kingkongola/lowrider/machine/delar/nollpunkt/fallarm_C_allt.jpg

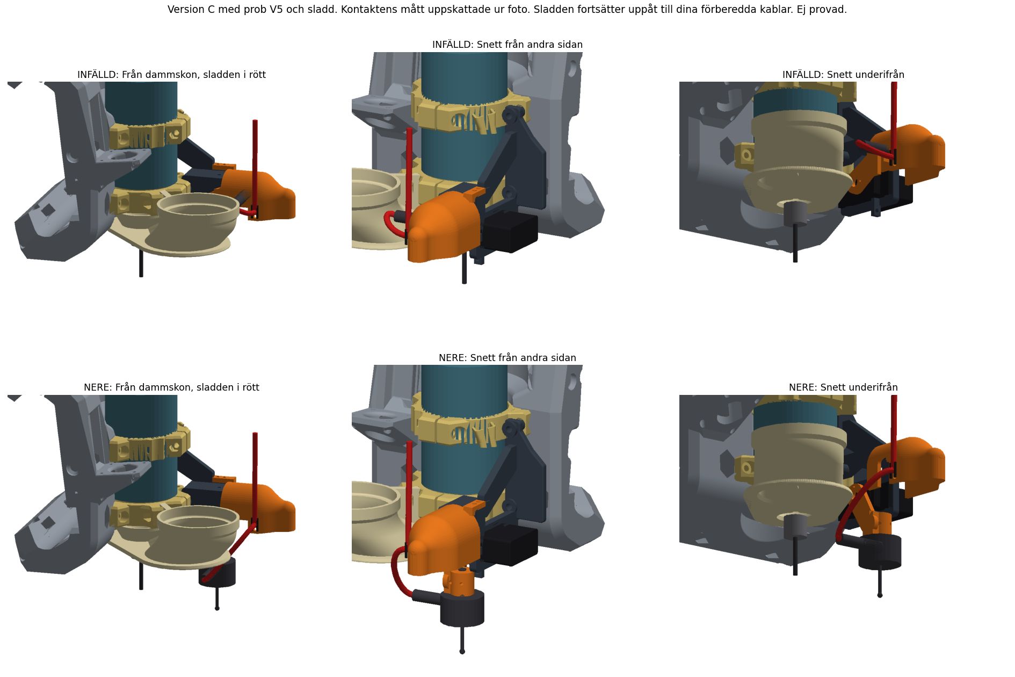
machine/delar/nollpunkt/fallarm_C_allt.jpg
