kingkongola/lowrider/README.md

# LowRider V4

Det här repot är single source of truth för den LowRider V4 som faktiskt byggs.

> **Läs detta först (2026-11-09):** De första avsnitten nedan är en **historisk bygg-/inköpssnapshot från september**, inte uppdaterad maskinstatus. LowRidern är **byggd och har fräst**, offerskivan planades senast 2026-10-22 och den permanent monterade mekaniken beskrivs i `BUILD_LOG.md`. Gällande **repo-konfiguration** pekas ut av `machine/AKTIV`; fysisk mätstatus finns i `CALIBRATION.md`, sensorbeställningar i `PROCUREMENT.md` och sensorernas design-/teststatus i `cnc/docs/PROJEKTJOURNAL_SENSORER.md`. **Z-nivå ännu inte verifierat färdig**, men squaring godkändes efter struts den 13 oktober (0,5 mm diagonalskillnad). Läs inte den äldre monteringsordningen som återstående arbete.

## Aktuell LED-status — beslut D022, 2026-11-10

**G4-lampor är ersatta av BRIMETI 24 V COB-list**, 4000 K/8 mm/320 LED/m, 5 m för angivna 145 kr Prime (10 W/m och 100 lm/W enligt säljaren). Tre banor under **horisontell understrut**, en nedåt och två framåt. **G4 ska inte köpas eller ritas till detta bygge.** [Låst komponent-/principval](DECISIONS.md#d022--cob-list-ersätter-g4-lampor-för-lowrider-belysning), [samlad SSOT för LED/el](machine/EL_BELYSNING_OCH_STOPP.md), [parametriskt CAD-utkast och spärrar](machine/delar/led/README.md). Aktuell build123d är **lågprofil med hårt Z-tak 6,65 mm för fästet** och startvinklar **0°/15°/35°**. Både 90°-felvänd version och tidigare cirka 21 mm hängande fäste är ersatta; **ingen fysisk passning, bild- eller temperaturtest godkänd**. Matning och NVR/automatisk övervakningsstopp är fortfarande öppna konstruktionsfrågor.

## Aktuellt läge — 2026-09-21

- Maskin: **LowRider V4**. PrintNC/IndyMill är inte aktiva alternativ.
- Arbetsyta: **650 × 1250 mm**.
- Geometri: rör **816 / 816 / 1505 mm**, Ø30×1,5 mm; strut-input **819 mm**; GT2 **999 / 1705 / 1705 mm**; minimum bord **941 × 1563 mm**; praktisk deck cirka **1000 × 1620 mm**.
- HaWiWe-order: **betald 1 853 kr och mottagen**, enligt användarens uppgifter. Ordervaluta 165,50 € inkl frakt. Innehåll: 6,0 mm XZ-plattor, 4 × MGN12H 150 mm, LR4 screw set och Makita/Elaire 1/8" collet.
- Controller: **Elecrow Jackpot3 `CQA240812C2` är mottagen**, faktisk debitering **937 kr** inklusive DDP Economy.
- Drive pulleys: **3 × GT2/2GT 16T / 5 mm bore / 10 mm belt är köpta via eBay/POWGE**, faktisk debitering **72 kr**, fri frakt och importavgifter inkluderade i eBay-köpet.
- LaskaKit-mekanikkärna: **mottagen**, 444 kr. Innehåll: 6 smooth idlers, T8×8 400 mm, 2 × 5→8-koppling och 5 m GT2 10 mm glasfiber. **4 × ersättnings-T8×8-mässingsmuttrar från Amazon är mottagna** (2 används + 2 reserv).
- Faktiskt betalt inklusive bordsskivan: **6 756,11 kr brutto**; **6 689,11 kr** exklusive 67 kr annullerad eBay-order som väntar återbetalning. Se `COSTS.md`.
- Mekanikinköp: grundmekaniken inklusive **3 × eBay/POWGE 16T-remhjul är mottagen**. Verifiera fysisk passning och antal mot beställningsspec innan montering. Köp inte T8-muttrar igen.
- Printer: **Bambu Lab P1S**; alla diameterberoende LR4-printar ska vara **30 mm-variant**, tool mount **Makita/65 mm**.
- Router: **KATSU 101750**, 710 W, cirka 65 mm; köpt.
- Filament: **3 kg PLA från PrintOnion** för 426 kr; utskrifterna är igång.
- Bord: **180×100 cm bordsskiva köpt för 300 kr**; ingen planerad 90 cm-kantbreddning, kontrollera underrede. Löstagbar ~12 mm MDF-spoilboard köps senare.
- Garagegrupp: **10 A**, praktiskt beprövad med svets; CNC är inte ett öppet elproblem om säkringen faktiskt håller.
- Dammhantering är del av grundbygget.
- **Maskinen körd 2026-10-04:** Jackpot3 (FluidNC 3.9.9, 192.168.50.184) styr maskinen; limits och homing fungerar. Kalibrering steg 1 (steps/mm **X 50,0835 / Y 50,2054**) och steg 2 (squaring, diagonalskillnad 1,6 mm; Y motor0 pulloff 6,2) är klara; steg 3 (Z-nivå) är uppskjutet till efter permanenta struts och planfräst offerskiva. Protokoll, mått och config-backuper: `CALIBRATION.md`, `machine/`. Squaring/Z-nivå görs om efter permanenta struts.
- Prints: användaren har rapporterat utskrift av **platta 14/14** samt att **hela Core är omprintad utan tidigare 0,20 mm förskjutning**. Den tidigare defekta Core används inte. **Det är inte bekräftat att det separata Makita/65 mm-verktygsfästet (eller Jackpot3-boxen) ingick i dessa plattor.** Se LR-00 och inventera utskrifterna före Core-montage.
- 3 × 16T-remhjul från eBay/POWGE: **mottagna 2026-09-21** enligt användaren; antal och tekniska mått kontrolleras under nästa inventering.
- Projektkostnad inklusive köpt bordsskiva: **6 756,11 kr brutto**, **6 689,11 kr** exklusive annullerad eBay-order på 67 kr som väntar återbetalning.

## Kanoniska filer

- `DECISIONS.md` — låsta beslut och explicita supersessions.
- `BOM.md` — exakt vad bygget behöver och vad som redan finns/köpts.
- `PROCUREMENT.md` — **enda kanoniska ordermatrisen** för kvarvarande köp.
- `COSTS.md` — **enda kanoniska kostnadsledgern**; faktiskt debiterade SEK-belopp.
- `CHECKLIST.md` — nästa arbete i fysisk ordning.
- `AUDIT.md` — mekaniska/elektriska/fysiska gates; innehåller inte flyktiga priser.
- `SOURCING.md` — daterad sourcing-evidens och länkar; ska inte duplicera en alternativ BOM.
- `TABLE.md` — bord/deck.
- `BUILD_LOG.md` — historik; gamla val får finnas här som historik men är inte current state.
- `WORK_ORDERS.md` — arbetskort om cirka en timme, med beroenden och återrapportering; lokal webbsidestatus är inte SSOT.
- `CALIBRATION.md` — kalibreringsprotokoll (steps/mm, squaring, Z-nivå) och enda mätloggen; baslinje-config i `machine/`.
- `CABLE_ROUTING.md` — kabellager, routing, mätprotokoll och verifierade kapmått (ännu tomma innan fysisk full-travel-kontroll).
- [`machine/EL_BELYSNING_OCH_STOPP.md`](machine/EL_BELYSNING_OCH_STOPP.md) — aktuellt 2026-11-10: 24 V-LED (ned/fram/fram), tillgängliga nätaggregat, separat övervakningsmatning, tänkt automatisk frånkoppling och återstående verifieringar. Inget färdigt elschema eller LED-klips.

## Monteringsguide

**Granskning 2026-09-29:** [resultat och öppna byggkontroller](AUDIT_2026-09-29.md). Rörgeometrin är omkontrollerad; T8 kräver provpassning före kap, kablar mäts en i taget och LR-22 ska godkännas före motorprov. Beräknade remlängder nedan skiljs från extra grovkapmarginal i manualen.

- [`docs/MONTERING_SV.md`](docs/MONTERING_SV.md) — svensk, utökad monteringsguide för den faktiska LR4-konfigurationen med **Jackpot3**. Läs tillsammans med V1E:s originalbilder; guiden ersätter inte kanoniska beslut eller checklistan.
- [Publicerad guide och arbetsordrar](https://kingkongola.github.io/lowrider/) — originalbilder inline, 30 entimmespass och kopierbar återrapport. Lokal status på webbplatsen synkas inte automatiskt med repot.
- `research/` — historisk evidens. Top-level-filerna ovan supersederar research vid konflikt.

## Sensorutbyggnad 2026-11-08

- [**Gemensam projektjournal**](https://github.com/kingkongola/cnc/blob/main/docs/PROJEKTJOURNAL_SENSORER.md) — historik, beslut, motiv, antaganden och nästa steg. Håll ingen kopia här.
- [Sensorarm: inkopplings- och provgrind](machine/delar/nollpunkt/INKOPPLING_OCH_PROV.md) — dokumenterad kontroll före **eventuell** inkoppling; inga steg fysiskt verifierade.
Enligt användaren är kamera, mikrofoner, accelerometer och BLTouch nu **beställda, ej mottagna**. [Orderstatus och obekräftade exakta orderrader](PROCUREMENT.md); [mjukvaruarkitektur och kodstart i cnc](https://github.com/kingkongola/cnc/blob/main/docs/sensorarkitektur.md). Sensorfunktionerna är inte monterade eller driftsatta.

## Pågående experiment och automationsidéer

- [Automatisering och kamera – idéer 2026-11-06](docs/AUTOMATISERING_OCH_KAMERA_2026-11-06.md): krav på kamerasystemet, Tapo/Coral, BLTouch på servoarm, vakuumfastspänning, Genie-frammatning/indexering, billig verktygsväxling och manuell tvåsidig registrering. **Forsknings- och provplan, inga låsta konstruktionsbeslut.**

## Aktuell arbetsordning

1. Inventera utskrivna LR4-delar. **Kontrollera explicit om det separat nedladdade Makita 701/65 mm-verktygsfästet finns; vid frånvaro skriv ut det enligt LR-00.** Verifiera även 30 mm-varianter, rätt Jackpot3-box och **4 × temporära struts (15 % infill)**. Platta 14/14 innebär inte att separat mount-set automatiskt ingick.
2. Kontrollera köpta 180×100-skivans underrede/styvhet och provlägg rail/belt-layout. Mät/kapa rör efter OD-/rakhetskontroll.
3. Inventera HaWiWe, DigiKey, remhjul och el-/kabeldelar mot BOM. Alla tre beställda 16T-remhjul är mottagna; kontrollera tänder/hål/rembredd före montering.
4. Köp/ordna ~12 mm MDF-spoilboard, 5–6 mm strutmaterial, första 3,175 mm-fräs samt NVR/kapsling efter fysisk dry-fit.
5. Montera maskinen med temporära struts, konfigurera Jackpot3, torrkör och fräs permanenta struts (`819`, `front_wing_size=10.8`) med maskinen själv.
6. Byt till permanenta struts, gör full-travel-test för kablar/slang, färdigställ dammhantering och planfräs offerskivan.

Bred komponentresearch ska inte återöppnas utan ett konkret pris-, lager-, kompatibilitets- eller integrationsproblem.
