kingkongola/lowrider/CHECKLIST.md

# Checklist

## LED-belysning – aktuellt beslut 2026-11-10 (D022)

- [x] **Valt komponent-/funktionsval:** BRIMETI COB 24 V / 4000 K / 8 mm / 320 LED/m; **G4-lampor utgår**. Rulle 5 m, uppgivet 10 W/m; 145 kr med Prime enligt användaren. Faktisk betalning/mottagning ej bekräftad.
- [x] Parametrisk **build123d-lågprofil** i [`machine/delar/led/tre_vinklar.py`](machine/delar/led/tre_vinklar.py): horisontell understrut, 3 × LED-riktningar med **provvinklar 0°/15°/35° och 9 mm hyllbredd för 8 mm LED**, och **hård Z-budget 6,65 mm för enbart fästet** under plattan. **Både felvända 90°-CAD:n och tidigare ~21 mm nedsänkta pelarversionen är ogiltiga.**
- [ ] Verifiera build123d-export i CI och att rätt STEP/STL ligger i aktuell artefakt; inga gamla STL/STEP.
- [ ] Kontrollera att aktuell CAD-export från build123d innehåller **rundade hörn och 0,2 mm hyllkantfas i **den nya 1,6 mm tunna hyllan****, inte bara den äldre kantiga modellen. Provprinta en ny export, inte tidigare uppladdad STL/STEP.
- [ ] Kontrollera **längsgående kantstag från lägre sidan av 15°-/35°-hyllorna upp mot 0,9 mm överdel**, anslutning mot central skruvad bas och böjstyvhet vid fria ändar; kontrollera att stagen är bakom ljusytorna. Kontrollera verkligt CAD-intrång **≤6,65 mm för själva fästet relativt understrutten** och mät separat LED-listens/tejpens tillkommande Z och verklig maskinfrigång med fräs/dammsko/arbetsstycke. Provprinta **ett** PETG-fäste; kontrollera två M5/Brace-låspunkter (56 mm c/c), skruvgrepp och hel XYZ-frigång innan full montering.
- [ ] Prova kort LED-sektion på PETG, 24 V och fullt ljus: yttemperatur, tejpens vidhäftning och kamerans skuggor/reflexer. **Aluminiumprofil är inte ett beslutat inköp.**
- [ ] Planera **3 × parallella lödda LED-grenar**, isolerade lödpunkter och dragavlastning, och en gemensam tvåledarmatning på balken. Prova först befintlig passage/kant; **om borrning krävs**, märk en enda genomföring efter kontroll av platta, M5/Brace, båda sidor och full XYZ, avgrada och skydda kabeln. Ingen hålposition eller diameter beslutad.
- [ ] Verifiera befintliga aggregat och dimensionera separat matning för installerad LED-längd; Pi/övervakningen ska fortsatt fungera efter maskinstopp. El-/stoppkrav: [`machine/EL_BELYSNING_OCH_STOPP.md`](machine/EL_BELYSNING_OCH_STOPP.md).

## 1. Beställningar — nu

- [x] LaskaKit mekanikkärna — köpt 2026-09-03 för **444 kr faktiskt debiterat**
- [x] 4 × **T8×8 brass nut, 2 mm pitch / 4-start / 8 mm lead** — Amazon.se/euroharry, **101,76 kr visat orderpris**, **mottaget 2026-09-10**
- [x] 3 × GT2/2GT drive pulley **16T / 5 mm bore / 10 mm belt / 2 mm pitch** — eBay/POWGE, **72 kr**
- [x] DigiKey — PSU, endstops, 608-lager, Wago, glands, Faston, kablage och pigtails, **986,98 kr**; **mottaget/hämtat 2026-09-09**
- [x] 5 × STEPPERONLINE `17HS19-2004S1` — Amazon.se, **608,37 kr visat orderpris**
- [x] Elecrow Jackpot3 `CQA240812C2` — **937 kr**
- [x] KATSU `101750` router — Amazon.se, **620,00 kr visat orderpris**
- [x] **3 kg PLA 1,75 mm från PrintOnion** — **426 kr**
- [x] **2 × Motonet-rör** — köpt 2026-09-07 för **340 kr totalt**; planerad spec Ø30×1,5×2000 mm

**Kärnmekanik, elektronik, router, filament och rör är köpta/beställda. Alla 3 × 16T-remhjul är mottagna 2026-09-21; kontrollera fysisk specifikation vid inventering.**

## 2. Lokalt / fysiskt

- [ ] räkna av DigiKey-paketets innehåll mot BOM före montering
- [ ] verifiera de köpta Motonet-rörens faktiska OD/rakhet/längd före kapning
- [ ] kapa rör först därefter: 1505 / 816 / 816
- [x] **180×100 cm bordsskiva köpt för 300 kr**, rapporterat 2026-09-19
- [ ] kontrollera underredets styvhet, höjd och infästning; ordna eventuell förstärkning bara vid behov
- [ ] markera 941×1563 mm footprint på den köpta skivan och kontrollera rail/belt-zoner; **ingen 90 cm-kantbreddning behövs**
- [x] 3 × 16T-remhjul från eBay/POWGE mottagna 2026-09-21
- [ ] kontrollera 16T, 5 mm hål och kompatibilitet med 10 mm GT2-rem före montering

## 3. När HaWiWe anländer

- [ ] kontrollera transportskada
- [ ] kontrollera fyra produktgrupper: XZ-plattor, 4 rails, screw set, collet
- [ ] provmontera M3×10 mot 6,0 mm XZ/MGN-block; inget bottnar/binder

## 4. Prints

- [ ] hämta senaste LR4-filer
- [ ] verifiera **30 mm** på alla railberoende delar
- [ ] **kontrollera om Makita/65 mm-verktygsfäste verkligen är utskrivet**. Det ingår inte bekräftat i våra 14 MakerWorld-plattor; V1E listar det som separat [Makita 701 Tool Mount and Dust Shoe](https://www.printables.com/model/1033926-makita-701-tool-mount-and-dust-shoe-for-the-lowrid).
- [ ] om fästet saknas: välj rätt 65 mm-variant för KATSU 101750; slic:a och skriv ut enligt modellbeskrivningen (V1E:s deltabell anger 30 % infill); kontrollera passning före Core LR-07. Se arbetsorder LR-00.
- [ ] kontrollera separat om **Jackpot3 board box** är utskriven (V1E länkar till en separat modell); anta inte att den följer med grundplattorna.
- [ ] provprinta `Z_Stub` + `Z_Nut`
- [ ] kontrollera passning; **Core är helt omprintad utan den rapporterade 0,20 mm förskjutningen** — denna felanmärkning gäller inte den nya Core
- [ ] granska slicer bridges/unsupported geometry
- [ ] inventera utskrifterna efter att användaren rapporterat platta 14/14: grundplattornas status, separat tool mount, Jackpot3-box och temporära struts verifieras var för sig.
- [ ] printa **4 × temporära struts, 15 % infill** för första monteringen
- [x] **monterade 2026-10-22 enligt användaren.** generera permanenta front-/bottenstruts med `strut_length=819`, `front_wing_size=10.8` (5–6 mm MDF/hardboard, max 6,35 mm); fräs med färdigmonterad LR4 och byt sedan ut temp-struts

## 5. Bord / spoilboard

- [ ] använd den köpta **180×100 cm** bordsskivan direkt som strukturell maskinbas, förutsatt godkänt underrede
- [ ] köp **inte** hel OSB/ply-deck om inte verkligt behov uppstår
- [ ] planera rail/belt-infästning på 180×100-skivan, utan tidigare planerad 90 cm-kantbreddning
- [x] offerskiva fastskruvad, rapporterat 2026-10-07 (material/tjocklek ej rapporterat; inte planfräst)
- [x] offerskivan planfräst (`plan07`, 0,7 mm), rapporterad plan 2026-10-22
- [ ] inget T-track före faktiskt behov

## 6. Mekanik

- [ ] montera gantry/Y/Z
- [ ] provpassa T8 på båda YZ-sidorna före kapning enligt manualens kapitel 0; 150 mm är provmått, D014:s 150–160 mm är inte automatiskt godkänt
- [ ] kontrollera lätt Z-rörelse utan binding
- [ ] kontrollera hela 5 m-rullens fördelning före första klippet: V1E beräknat 999 / 1705 / 1705 mm; vår extra grovkapmarginal ger minst 1029 / 1735 / 1735 mm. Trä remmar i LR-08/09/10; slutspänn efter LR-16
- [ ] montera 16T/rem/idlers
- [ ] montera KATSU `101750` i Makita/65 mm mount
- [ ] provpassa Elaire-collet
- [ ] kontrollera runout
- [ ] kontrollera fri manuell rörelse över hela slaget
- [ ] squara maskinen

## 7. Damm

- [ ] bekräfta DeWalt-typskylt
- [x] printa LR4 dust shoe (dammsugning monterad 2026-10-22 enligt användaren)
- [ ] prova befintlig TPU till bristles
- [ ] printa cyklon: **eifelbiker "Cyklonseparator med undertrycksventil"** (MakerWorld, `Zyklon.3mf`), P1S-profil, PLA, 3–4 väggar, ~18,7 h; TPU-packningar (separat profil, 1,7 h); egna 46 mm-stosar mot slangen; ventilens fjäder 0,5×6×20 mm + M3x25/M4x35 + mutterinsatser M3/M5 behövs. Utskrift påbörjad 2026-10-16 (användarens rapport); ej verifierad klar.
- [ ] ordna 15–30 l styv behållare
- [ ] vakuumtesta behållare/lock kontrollerat
- [x] **Slang finns redan:** 4 meter poolslang, ID 46 mm (uppmätt 2026-10-14); användaren har använt den med DeWalt för att rengöra FTX-kanalerna. Inget nytt slanginköp behövs i nuläget. DeWalt-originalslang är för kort.
- [ ] **Anpassa och verifiera sugslang på LowRider:** dammsugaren monterad 2026-10-22 enligt användaren; slangmått mätt (ID 46 mm) och adapter till Makita-dammskon printad (`slangadapter_46mm`, cnc-repot); kvar: ordna upphängning/dragavlastning och prova full X/Y/Z-rörelse. Beakta att vanlig poolslang normalt inte är antistatisk.
- [ ] bygg slangavlastning
- [ ] lös statisk jordväg före XPS/reguljär MDF/trä-drift

## 8. Controller/lågspänning

- [ ] inventera data-USB-C
- [ ] inventera FAT32 microSD >2 GB
- [ ] när Jackpot3 anländer: kontrollera transportskada/korrekt kort
- [ ] montera Jackpot3 luftigt på rörlig beam/YZ_Min-sida
- [ ] provplacera även HDR-60-24 på balken; verifiera skyddad 230 V-anslutning, kapsling, DIN-infästning, ventilation och dragavlastning innan anslutning; HDR är klass II utan PE-plint
- [ ] flasha V1E:s då aktuellt testade FluidNC + rätt LR4-config
- [ ] koppla motorer
- [ ] första jogg 1 mm först efter godkänd nätmatning/stopp (LR-22), kabeldragning och brytarprov
- [ ] **LR-08: BEKRÄFTAT PASSNINGSFEL:** köpta 3×26 AWG-kabelns cirka Ø4 mm mantel går inte genom Core. **Tvinga inte in den.** Prova individuellt isolerade innerledare enbart genom tunneln med oskadad isolering, avlastad mantel utanför och skavskydd; alternativt tunnare flexibel tvåledarkabel/skyddad yttre dragning. Kontrollera även YZ-kanalernas passning. Förbered med märkt dragtråd om kabelvägen ännu inte är mätbar; vid LR-16 mäts och kapas en brytarkabel i taget från rullen. **250 cm är inte verifierat kapmått.** LR-16: kontrollera full rörelse och kapa först efter faktisk dragning.
- [ ] koppla 5 endstops NC via COM+NC
- [ ] verifiera varje endstopstatus

## 9. NVR/elbox + full travel

- [ ] välj NVR efter faktisk variant/schema; Clas Ohlson KJD12 230 V/10 A är aktiv kandidat
- [ ] dry-fit fast NVR och balkmonterat HDR-60-24 med separat beröringsskydd; bestäm kapsling och håltagning först efter fysisk kontroll
- [ ] placera stoppet direkt nåbart
- [ ] dry-fit kort 24 V-rutt mellan balkmonterat HDR-60-24 och Jackpot3; den köpta 3 m-kabeln är reserv, inte obligatorisk rörlig slinga
- [ ] dry-fit säker nätmatning till balkmonterat HDR-60-24
- [ ] dry-fit KATSU-kabel
- [ ] dry-fit motor/endstop
- [ ] montera vac-hose samtidigt
- [ ] kör manuellt alla fyra hörn + Z-extremer
- [ ] slutlig dragavlastning först efter godkänt full-travel-test

## 10. 230 V verifiering

- [ ] följ exakt terminalschema
- [ ] PE kontinuerlig/oswitchad
- [ ] kontrollera kabel-OD mot glands
- [ ] inga åtkomliga live-delar med boxen stängd
- [ ] kontinuitetstesta PE
- [ ] verifiera ingen L/N→PE-kortslutning
- [ ] verifiera NVR/no-restart med router frånkopplad

## 11. Driftsättning

- [ ] torrkör utan fräs
- [ ] verifiera full driven travel
- [x] kalibrering steg 1 (steps/mm) och 2 (squaring) enligt CALIBRATION.md, 2026-10-04
- [ ] kalibrering steg 3 (Z-nivå) efter permanenta struts (klart 2026-10-22) + planfräst offerskiva; gör om squaring då
- [ ] plana spoilboard
- [ ] kontrollera X/Y-mått + diagonaler
- [ ] kontrollera Z-djup
- [ ] fräs kalibreringsbit
- [ ] spara fungerande config-backup
- [ ] första enkla jobb i billigt material

## Senare — inte nu

- [ ] hel deck/torsionsbox endast om det faktiska bordet visar att det behövs
- [ ] Sorotec/extra fräsorder när första verkliga fräsbehoven är kända
- [ ] router-/stepperförlängning endast om dry-fit kräver
- [ ] T-track/insert-grid/vacuum-table efter erfarenhet
- [ ] laser tidigast 2027
- [ ] plasma utanför detta bygge
