kingkongola/lowrider/CABLE_ROUTING.md

# Kabeldragning och verkliga kabellängder — LowRider 4

**Status 2026-09-29: kaplängd ej verifierad.** För vår arbetsyta 650 × 1250 mm och Jackpot3 på YZ_Min finns **inget av V1E angivet exakt X-brytarkabelmått**. Tidigare förslag 250 cm var en oprövad uppskattning och har dragits tillbaka som kapinstruktion. Prova kabelpassningen i LR-08 och lämna märkt dragtråd om längden ännu inte kan mätas. Fastställ faktisk längd i LR-16; om 250 cm redan är kapat, behåll biten och prova räckvidden innan vidare kapning.

## Vad finns och vad är faktiskt känt?

| Kabel/del | Köpt längd/antal | Användning eller status |
|---|---|---|
| 5 × STEPPERONLINE 17HS19-2004S1 | **1 m fast motorkabel per motor** | Y0, Y1, Z0, Z1, X. Ändra inte motorernas fasta kablar. |
| Tensility 30-00377 | **10 m 3×26 AWG**, svart mantel cirka Ø4 mm | Fem NC-brytare, COM + NC. **ANVÄNDAREN HAR VERIFIERAT ATT MANTELN INTE PASSAR I CORE-TUNNELN.** Behåll manteln på rörlig del; pröva två separata individuellt isolerade innerledare endast i den trånga, fasta tunneln med skyddad övergång och avlastning. Alternativt tunnare flexibel tvåledarkabel/skyddad yttre kabelväg. Kontrollera passning även i YZ-kanaler. |
| Molex KK 2,54 mm 2-polig pigtails | **3 × 150 mm** | Kontaktförsörjning enligt BOM; matchning mot fysisk Jackpot3-ingång och antal behöver verifieras, särskilt eftersom fem brytare används. |
| Tensility 30-00416 | **3 m 2×20 AWG** totalt | Tidigare tänkt lång 24 V-slinga. Efter D016 behövs bara en kort HDR→Jackpot3-förbindelse på balken. Validera kabelarea, anslutningssätt och verklig ström innan användning. |
| 230 V till HDR och KATSU | Inget slutligt ruttmått | Rörlig kabelväg och beröringsskydd/PE/dragavlastning verifieras separat innan nätanslutning. Ingen kapning eller inkoppling enbart med detta dokument. |

**V1E:** [LR4 Core Assembly](https://docs.v1e.com/lowrider/#core-assembly) anger minst **140 mm fri ledning för eventuell touchplate** vid Core. Det är **inte** ett mått för X-brytaren. [Wire Routing](https://docs.v1e.com/lowrider/#wire-routing) anger förlängningar på Core och YZ_Max-sidan, full Z- och X-rörelse samt dragavlastade skarvar, men **inte exakta kapmått för vår maskinstorlek**. V1E:s BOM har tre motorkabelförlängningar som typkonfiguration.

## LED under horisontell understrut – plan 2026-11-10

**D022:** Tre 8 mm BRIMETI COB-banor under den horisontella understrutten (en ned, två fram). Varje remsa löds med +24 V/GND och parallellkopplas, sedan går **en gemensam lågspänningsmatning** mot valt LED-aggregat. För cirka 3 × 0,8 m gäller säljaruppgift 24 W totalt (~1 A vid 24 V). Ska inte antas få effekt från motorernas HDR-60-24.

**Håltagning:** undersök först befintlig öppning eller kabelväg via kant. Om kabelgenomföring krävs: borrning av **ett hål** är en möjlig metod, men **diameter och koordinat är inte mätta/beslutade**. Kontrollera båda sidor om plattan och verkliga M5/Brace-låspunkter, bärande smala sektioner, rör, rörelse/kollision. Hålet ska avgradas/skyddas och kabeln dragavlastas nära LED-lödningen och vid genomföringen. Inga nya hål i CAD före vald fysisk rutt. Lågspänningskabel och nätspänning ska inte samsas oskyddat. Märk kablar, säkra LED-grenen och fullfölj böj- och dragprov genom hela X/Y/Z-slaget.

[LED-CAD och kontrollgrind](machine/delar/led/README.md) · [Samlad el-/stopp-SSOT](machine/EL_BELYSNING_OCH_STOPP.md).

## Mätprotokoll – fylls efter fysisk provmontering, före kapning

| Ledning | Start → slut / faktisk väg | Köpt ledning | Mätt rutt inkl. rörelsemarginal | Slutlig längd | Funktion godkänd |
|---|---|---|---|---|---|
| X motor | Core → med Core till X_Max → avlastad mitt på balken → Jackpot3 YZ_Min | fast 1 m + ev. förlängning | — | — | ☐ |
| X NC | X-brytare → Cores tunnel → avlastad rörlig slinga via balkens mitt → Jackpot3 | passningsprov/dragtråd i LR-08; separat kabel från rullen vid LR-16 | prova fullt X-slag | ej fastställd | ☐ |
| Y0 motor | YZ_Min → kabelkanal → Jackpot3 | fast 1 m | — | — | ☐ |
| Y0 NC | YZ_Min-brytare → kabelkanal → Jackpot3 | ur 10 m 3×26 AWG | — | — | ☐ |
| Z0 motor | Z0 → YZ_Min-kanal → balk, med Z i full höjd → Jackpot3 | fast 1 m | — | — | ☐ |
| Z0 NC | Z0-brytare → samma Z-rörliga kanal → Jackpot3 | ur 10 m 3×26 AWG | — | — | ☐ |
| Y1 motor | YZ_Max → balk/stag → Jackpot3 YZ_Min | fast 1 m + ev. förlängning | — | — | ☐ |
| Y1 NC | YZ_Max-brytare → balk/stag → Jackpot3 | ur 10 m 3×26 AWG | — | — | ☐ |
| Z1 motor | Z1 → YZ_Max-kanal → balk/stag → Jackpot3 | fast 1 m + ev. förlängning | — | — | ☐ |
| Z1 NC | Z1-brytare → YZ_Max-kanal → balk/stag → Jackpot3 | ur 10 m 3×26 AWG | — | — | ☐ |
| HDR → Jackpot3 | Båda på balken, kort avlastad DC-rutt | ur 3 m 2×20 AWG endast om lämpad | — | — | ☐ |
| KATSU 230 V | Fast matning → hela Y-slaget → balk → hela X-slaget → fräs | befintlig fräskabel | — | — | ☐ |
| HDR 230 V | Fast NVR → hela Y-slaget → skyddad HDR-plint på balken | ännu inte valt | — | — | ☐ |
| Dammsugarslang | Dammuppsamling → avlastning → hela Y-/X-slaget → shoe | befintlig slang | — | — | ☐ |

**Praktisk ruttkontroll (projektmetod, inte V1E:s kapmått):**

1. **Vid LR-08 (Core):** den köpta **cirka Ø4 mm mantlade 3×26 AWG-kabeln passar bekräftat inte genom Cores tunnel**. Försök inte tvinga in den. För en fri ände från rullen kan du varsamt avlägsna *endast den korta del av ytterhöljet som faktiskt behövs för själva Core-tunneln och brytaranslutningen*; för två individuellt isolerade ledare genom tunneln om de går utan att nypas. Behåll manteln på hela den yttre rörliga kabelvägen. Avlasta manteln utanför Core; kontrollera skav/övergång och skadad isolering. Om lösningen inte är mekaniskt skyddad, välj tunnare flexibel tvåledarkabel eller säker yttre rutt. Märk `X`, anslut COM + NC enligt terminalmärkning och isolera oanvänd ledare. **Kapa inte hela kabeln vid Core.** Om kabelvägen inte är mätbar: lämna märkt dragtråd och färdigställ ledningen vid LR-16; behåll åtkomst till brytarens anslutning. En eventuell touchplate har separat kabel med V1E:s minst 140 mm fria längd.
2. **Vid LR-09/10 (YZ):** prova kabelpassningen och lägg separata märkta dragtrådar i kanalerna innan hjul och skenor blockerar åtkomsten; märk `Y0/Z0` respektive `Y1/Z1`. Fem separata kablar kan inte alla vara anslutna till samma okapade rulle. Redan kapade bitar används endast efter räckviddsprov. Prova Z genom hela slaget innan du fixerar ledningarna.
3. **Vid LR-13/16 (full maskin):** placera Jackpot3 på YZ_Min. Mät först alla fem brytarrutter med snöre inklusive rörelseslingor, kontakter och arbetsmån; summera och jämför mot återstående kabellager. Lägg sedan en verklig kabel i taget längs sin väg. Flytta Core till **X_Min och X_Max**, båda Z-sidorna till sina ytterlägen och balken genom **hela Y-slaget**. Lägg med fräskabel och slang i samma prov, och identifiera avlastade fixpunkter. Kabel ska vara fri även när maskinen går mot hörnen. V1E visar att X-ledningar går via Core och fästs ungefär mitt på balken.
4. **Mät och dokumentera varje ledning separat.** Lämna en mjuk service-/rörelsemarginal vid anslutningar och kopplingar – **cirka 10–15 cm kan vara en praktisk startpunkt, men är inte ett fast V1E-mått och måste anpassas efter rutt och böjradie.** För kort kabel eller stum förbindelse är inte godkänt. Fäst ledningar med avlastning före kontakt/skarv; motorförlängningar får inte bära draglast. Kablar som upprepat böjs måste vara avsedda för det.
5. **Kapning:** börja med X, använd dragtråden, anslut/avlasta brytaränden och mata fram till Jackpot3. Märk kapstället vid kortänden inklusive arbetsmån och eventuell pigtail; prova alla ytterlägen före klipp. Anteckna kaplängden och kvarvarande rulle. Upprepa för Y0/Y1/Z0/Z1 enligt den uppmätta fördelningen, inte en antagen 7,5 m-rest. Färdigställ fem verifierat passande kontakter (tre inköpta pigtails är inte fem). Överlängd kan förvaras dragavlastad på balken. Komplettera BOM endast vid faktiskt underskott.
6. **230 V:** bara planera mekanisk kabelväg i detta steg. Kabeltyp, PE, kapsling, dragavlastning, NVR och anslutning ska kontrolleras separat av elkunnig person. Den köpta lågspänningskabeln används inte för 230 V. HDR-60-24 har ingen PE-plint och är ingen jordpunkt; följ Mean Wells installationsmanual. LR-22 ska vara godkänd före första användning av HDR.

## Återrapport från LR-16

Skicka bilder på Jackpot3:s placering och kabelvägarna. Ange alla fem kaplängder, återstående kabel och kontaktlösningar, särskilt **vilken X-kabellängd som faktiskt räcker** genom fullt X-slag och om någon annan ledning är för kort eller behöver förlängning. Om 250 cm redan har kapats, ange om den biten fungerar. Överlängd får ligga dragavlastad.
