kingkongola/lowrider/TABLE.md

# Bord / underrede — aktuell status 2026-09-19

## Köpt och låst

- **180 × 100 cm begagnad bordsskiva köpt för 300 kr**, rapporterat 2026-09-19.
- LR4:s planerade arbetsyta: **650 × 1250 mm**; minimum ytterfootprint **941 × 1563 mm**.
- Den köpta skivan räcker för footprint på båda axlarna. **Ingen lokal kantbreddning för 90 cm-bord behövs.**
- Använd befintlig skiva som strukturell maskinbas om underredet är styvt och tillåter säker rail-/belt-infästning.
- Köpt skiva ingår i `COSTS.md`. Underredets faktiska skick, utformning och behov av förstärkning är **inte verifierat**.

## Gör nu

1. Verifiera underredets styvhet: tryck i hörnen, kontrollera glapp, sarg/tvärstag och beninfästningar.
2. Mät bordshöjd, skivans planhet och var det går att fästa rails, remclips, kabel och slang.
3. Markera 941 × 1563 mm och provlägg rörelsezoner innan du skruvar/borrar.
4. Köp endast underredesmaterial/förstärkning om kontrollen visar konkret behov.
5. Köp en löstagbar cirka **12 mm MDF-offerskiva** till arbetszonen; fräs den plan med färdigmonterad LowRider. Offerskivan behöver inte täcka hela bordsskivan eller bära rails.

## Köp inte i onödan

- Ingen ny bordsskiva eller full OSB-/plywood-deck som standard.
- Ingen kantbreddning avsedd för det tidigare alternativet 180 × 90 cm.
- Ingen T-track, vakuumbord eller torsionsbox före ett verifierat behov.
- Inga hjul före första fungerande maskinen.

## Bord, damm och el

Planera utrymme för befintlig DeWalt-dammsugare, printad cyklon, 15–30 l uppsamlingskärl samt slangavlastning. NVR/maskinstopp placeras fast och åtkomligt; Jackpot3 och, efter kontrollerat beröringsskydd/kapsling, HDR-60-24 planeras på rörlig balk enligt D016. Testa hela rörelseområdet för kablar och slang innan slutlig infästning.

Äldre 180 × 90-bordstrategi med ~41 mm breddbrist är **historik, inte aktiv köp-/byggplan**.

## Offerskivan

Hål (styrhål) och skruvar i offerskivan, i maskinkoordinater: `OFFERSKIVA.md`.
