kingkongola/lowrider/AUDIT_2026-09-29.md

# Granskning av svenska byggmanualen – 2026-09-29

**Resultat: konkreta instruktioner har rättats. Bygget är inte fysiskt slutgodkänt.** En genomgång av dokument kan inte garantera kapning, passning eller säker drift utan mätningar på de verkliga delarna.

Granskningen omfattar dagens inklistrade ändringshistorik, aktuell svensk manual/webbtext, kabelprotokoll, arbetskort, BOM, beslut och checklistor. Befintliga lokala manualändringar har bevarats och kompletterats. Inga inköp, leveranser eller fysiska byggmoment har markerats godkända.

## Kapmått och vad de betyder

| Del | Underlag | Åtgärd före kapning |
|---|---|---|
| X-rör | 2 × 816 mm | Kontrollera OD, rakhet och två lika färdiga längder; sågspår i spillet |
| Y-rör | 1505 mm | Kontrollera OD/rakhet och bordslayout |
| Stag | inmatning 819 mm, front_wing_size 10.8 | Inte rörmått. Kontrollera genererad ritning och CAM; långsidan längs Y |
| Remmar | beräknat X 999, Y 1705 + 1705 mm | Projektets extra grovkapmarginal: minst 1029 / 1735 / 1735 mm; markera alla tre på rullen först |
| T8 | V1E anger 145 mm eller längre; projektets provmått 150 mm | Verifiera båda sidors verkliga gängingrepp och frigång före kapning |
| Fem brytarkablar | inget fast kapmått verifierat | Mät alla rutter, kontrollera totalen och färdigställ en kabel i taget |
| Motorledningar | 1 m per köpt motor enligt BOM | Behåll hela; mät eventuellt förlängningsbehov |

Kalkylatorns aktuella JavaScript hämtades och räknades om med X=650, Y=1250 och XZ=6,0 mm. Formlerna ger X-rör 816, Y-rör 1505, stag 819, remmar 999/1705/1705 och minimum bord 941 × 1563 mm. Två 2000 mm-rör räcker med normal sågspårsbredd. Bordsskivan 1800 × 1000 mm rymmer det beräknade footprintet; dess styvhet och infästningszoner är fortfarande oprövade.

Källor: [V1E-kalkylator](https://docs.v1e.com/lowrider/calculator/) och [kalkylatorns kod](https://raw.githubusercontent.com/V1EngineeringInc/V1EngineeringInc-Docs/master/docs/lowrider/calculator.js). Material, montage och T8-specifikation jämfördes med [V1E LR4](https://docs.v1e.com/lowrider/).

## Fel och luckor som rättats

1. **T8 kapades för tidigt i texten.** Ett katalogmått på 145 mm bevisar inte vårt färdiga montage. Ovillkorlig 2 × 150 mm-kapning och påståendet om 5 mm avfasningsmån har ersatts med provpassning före kapning, enligt D014. Restlängden beror på sågspåret.
2. **För kort remrulle saknade stoppgräns.** Ingen automatisk nedkortning längre. Alla tre segment markeras före första klippet. 4499 mm är grovkapplanens nominella summa; tandmellanrum kan kräva liten avrundning uppåt. V1E:s beräknade summa är 4409 mm.
3. **Remmarginal framställdes som krav.** 30 mm är vår reserv. En redan kapad 999/1705 mm-rem döms inte ut bara för att den saknar reserv. Låsöglorna runt M3 skiljs från onödiga veck. Remkraft förväxlas inte med en vikt hängd mitt på remmen.
4. **Fem kablar skulle sitta kvar på samma rulle.** Dragtrådar och åtkomliga anslutningar används under tidigt montage. Därefter mäts hela kabelbudgeten och en separat ledning färdigställs åt gången. 10 m och 10–15 cm arbetsmån utlovas inte som tillräckligt utan mätning.
5. **Arbetskorten motsade manualen.** LR-08/09/10 trär remmar tidigt, LR-11 verifierar T8 före sågning och LR-16 levererar de färdiga brytarkablar som LR-20 förutsätter. LR-15 beror nu på LR-16.
6. **Motorprov kunde komma före elkontroll.** LR-21 kräver LR-22. Kapitel 7 kräver godkänd nätmatning före användning av HDR. Dokumenterade fel räknas inte som godkänd installation eller motorprov.
7. **HDR-montage och jordpunkt var otydliga.** V1E:s foto av ett annat aggregat ersätter inte Mean Wells DIN- och ventilationskrav. HDR-60-24 är klass II utan PE-plint. Slangjord ska inte improviseras via aggregatet eller DC-minus. Spänning och polaritet ska verifieras före anslutning av kortet.
8. **Första genomskärningen saknade tydligt offerskydd.** Offerunderlag behövs redan vid första provet; slutlig planfräsning kommer senare. CAM behöver kontrollerade enheter, nollpunkt, säker Z och verktygsbana. KATSU:s manuella drift anges uttryckligen.
9. **Stagets riktning i CAM var för valfri.** Cirka 819 mm ryms inte i 650 mm X. Långsidan läggs längs Y och hela banans yttergränser kontrolleras. Generatorns avsiktliga underlängd ska inte skalas bort.
10. **Webb och text behövde synkas.** Även maskinöversikten visas i förberedelserna. Bildernas stegplacering har kontrollerats; Jackpot3-kopplingen använder rätt kortbild. Ändrade kontrollrutor får inte ärva ett godkännande för en annan instruktion.

Elunderlag: [Jackpot3](https://docs.v1e.com/electronics/jackpot3/), [HDR-60 datablad](https://www.meanwell.com/Upload/PDF/HDR-60/HDR-60-SPEC.PDF) och [HDR installationsmanual](https://www.meanwell.com/Upload/PDF/HDR%20DIN%20rail%20power%20supply.pdf). Jackpot3-dokumentationen anger vid denna kontroll FluidNC 3.9.9/WebUI V3. Installerad firmware och verklig config har inte lästs från användarens kort.

## Fysiska kontroller som fortfarande behövs

- Rörens diameter/rakhet, XZ-plattornas tjocklek och skruvarnas gängingrepp.
- T8-muttrarnas passning samt godkänd längd/frigång på båda sidor.
- Kompletta 30 mm-printar, rätt fräsfäste, Jackpot3-box och bordets styvhet.
- Core-kabelns skyddade passage; fem passande brytarkontakter (BOM listar bara tre pigtails); verkliga motorförlängningar.
- Verklig NVR-modell, kapsling, nätinstallation, stopp/återstartsskydd och uppmätt DC-matning.
- Fräshylsans passning, verktygsinfästning, dammsko, slang, behållare och separat bedömd statisk jordväg.
- Full rörelse med samtliga kablar/slang, brytarprov, homing och måttprov före större fräsjobb.

Fyll faktiska resultat i [CABLE_ROUTING.md](CABLE_ROUTING.md), [CHECKLIST.md](CHECKLIST.md) och [BUILD_LOG.md](BUILD_LOG.md). Använd [manualens kapitel 0](docs/MONTERING_SV.md) som kapunderlag; detta protokoll ersätter inte monteringsstegen.

## Kontroll av dokumentleveransen

- Alla 12 webbkapitels texter jämförda med markdown-källan, inklusive maskinöversikten.
- Alla 31 arbetskort jämförda mellan markdown och JSON; beroendena saknar cirklar och innehåller kabel-/elkontroller före beroende moment.
- 159 bildposter har giltiga placeringar. Alla kapitel renderades i kodkontroll och öppnades via direktlänk i lokal webbläsare; inga konsolfel registrerades. Automatiserade klick i förhandsvisningen gav ingen synlig effekt, så knappnavigation är inte verifierad genom det provet.
- JavaScript-syntax och `git diff --check` godkända. Ingen fysisk maskinprovning utförd.

Ändringarna är lokala i repot. Ingen publicering till GitHub Pages har gjorts i denna granskning.
