kingkongola/lowrider/research/2026-08-29-table-live-candidates.md

---
research_date: 2026-08-29
last_updated_at: 2026-08-29
scope: live used-table candidate pass for the locked ~1000x1620 LR4 deck, focused on Gävle/Gävleborg
status: recommendation-ready
decision_state: no purchase-ready jackpot table is verified yet; one current 700 SEK Gävle lead is worth checking for dimensions/underframe, while two earlier search leads could not be re-verified and must not be treated as live
price_basis: indexed marketplace observations checked again 2026-08-29; availability, dimensions and seller details must be verified on the live listing before pickup
region: Gävle / Gävleborg / Sweden
sources_checked:
  - Relovie Gävleborg current matbord aggregation
  - Blocket current matbord search/index
  - Blocket current Gävle furniture index
supersedes: null
---

# Live table candidate pass — Gävle, 2026-08-29

This pass applies the already-locked rules in `TABLE.md` and `research/2026-08-29-table-base-local-sourcing.md` rather than reopening table architecture.

## Locked buy target

Preferred geometry:
- 1800×1000 mm — jackpot
- 1800×900 mm — very good
- roughly 1600–1800 × 850–1000 mm can work if the underframe is genuinely stiff

Price rule:
- 0–400 SEK: strong buy if dimensions + racking test pass
- 400–700 SEK: normal Pareto zone
- 700–1000 SEK: only for clearly excellent commercial/stiff construction
- >1000 SEK: normally wait

The practical LR4 deck remains ~1000×1620 mm, so an 1800×900 table only leaves 50 mm deck overhang on each long side.

## Current verified lead

### Gävle — “FYNDA!! Robust matbord i fint skick” — 700 SEK

Current Relovie Gävleborg aggregation, crawled 2026-08-28, shows:
- location: **Gävle**
- title: **FYNDA!! Robust matbord i fint skick**
- condition: **Bra skick**
- price: **700 SEK**

Source:
- https://relovie.com/k/hem-inredning/mobler/bord/i/gavleborg?type=matbord

### What is *not* verified yet

The indexed aggregation does **not** expose enough information to verify:
- length
- depth
- exact underframe construction
- whether “robust” means low racking rather than just a thick-looking top

Therefore this is **not purchase-ready yet**.

Next action for this lead:
1. open the underlying seller listing if still active
2. verify exact L×D×H
3. inspect/ask for underside/leg-frame photos
4. only pursue if geometry is roughly inside the locked target and the physical racking test can be done before pickup

At 700 SEK it must be a genuinely good 180×90/100-class table; merely being a usable table is not enough.

## Earlier leads that are NOT currently verified

An earlier search pass mentioned:
- a Gävle table around **180×95 cm**, reportedly bortskänkes
- a Gävle **180×90×76 cm** table around **900 SEK**

Fresh targeted searches on 2026-08-29 did **not** reproduce either listing reliably. They may have been removed, stale-indexed, or inadequately identified in the earlier pass.

**Do not treat either as current stock or a buy recommendation.** They can be reconsidered only if the live listing is found again.

This corrects the earlier conversational shortlist rather than preserving uncertain marketplace claims as facts.

## Market liquidity check

The wait-for-a-good-table strategy still holds.

Current indexed signals checked 2026-08-29:
- Relovie reports **228** used matbord in Gävleborg across three aggregated marketplaces.
- Blocket's broad current `matbord` index shows **167** results in Gävleborg.
- Blocket's Gävle furniture index shows **179** current furniture listings overall, including private listings and some bortskänkes inventory.

Sources:
- https://relovie.com/k/hem-inredning/mobler/bord/i/gavleborg?type=matbord
- https://www.blocket.se/recommerce/forsale/search?q=matbord
- https://www.blocket.se/recommerce/forsale/search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

These counts do not mean 167/228 tables match LR4 geometry. They only support the earlier conclusion that the local used-table market is liquid enough that we should not overpay for a mediocre base.

## Result

No reason to change `TABLE.md` architecture.

Current table state:
- **architecture: locked** — used stiff table + removable ~1000×1620 deck
- **buy thresholds: locked**
- **best currently re-verified lead: 700 SEK Gävle “robust matbord”, dimensions still unknown**
- **no verified jackpot 180×90/100 listing yet**
- **no monitoring/bevakning requested**

The next table work should only be live candidate verification/pickup, not more construction theory.
