kingkongola/lowrider/research/2026-08-29-pla-bulk.md

---
research_date: 2026-08-29
last_updated_at: 2026-08-29
scope: bulk PLA for printing LowRider V4 structural parts
status: recommendation-ready
decision_state: Pareto default is now 6×1 kg SUNLU regular PLA via current Mix & Match bulk tier around €9.19/kg; 5 kg giant spool remains absolute raw-price option but is no longer default; Creality Soleyin 6 kg remains excellent if its currently sold-out combo returns
price_basis: official SUNLU and Creality Europe pages observed 2026-08-29; EUR→SEK reference 1 EUR = 11.1274 SEK; Sweden checkout/stock remains authoritative
region: Sweden / EU
sources_checked:
  - SUNLU official Europe storefront regular PLA Mix & Match / MOQ 6 kg
  - SUNLU official 5 kg large-spool PLA listing
  - Creality EU Soleyin Ultra PLA product/bulk pages
  - previous Amazon.se / Swedish fallback research
supersedes: earlier recommendation in this file that the 5 kg giant SUNLU spool should be the default first choice
---

# Bulk PLA for LowRider V4

## Requirement

LowRider V4 structural print consumption is roughly **2.7 kg**.

Buy enough for:
- full machine
- failed/reprinted parts
- dust shoe / adapters / fixtures
- useful matching spare material

Practical purchase target: **~6 kg**.

Material rule:
- ordinary stiff PLA is the baseline
- do not choose silk, wood, CF or matte merely because a sale price is attractive
- PLA+ / high-speed is not automatically better for LR4 stiffness

## New Pareto winner — SUNLU ordinary PLA, 6 × 1 kg Mix & Match

Current official SUNLU regular-PLA bulk page:
- 1.75 mm
- ±0.02 mm dimensional tolerance
- ordinary PLA
- normal 1 kg spools
- Mix & Match / bulk pricing
- current 6-roll tier advertised from **€9.19/kg**
- SUNLU states free shipping to most EU regions

Sources:
- https://store.sunlu.com/sv-de/products/over-6kg-of-pla-pla-meta-3d-filaments-1kg-2-2lbs-fit-most-of-fdm-printer
- https://store.sunlu.com/sv-es/products/over-6kg-of-pla-pla-meta-3d-filaments-1kg-2-2lbs-fit-most-of-fdm-printer

### Cost

At the advertised 6-roll tier:
- 6 × €9.19 = **€55.14**
- at the 2026-08-29 reference rate ≈ **614 SEK total**
- ≈ **102 SEK/kg**

Final Sweden checkout can still change this slightly; verify destination, discount and shipping before payment.

### Why this beats the giant spool as our default

Compared with one 5 kg spool:
- uses standard spool holders/dry boxes
- no special heavy-spool stand/bearings required
- six individually sealed rolls
- easy to keep spare material dry
- Mix & Match allows a deliberate colour scheme
- if one spool has a problem, the entire 5 kg supply is not affected
- ~6 kg gives much more useful margin than exactly 5 kg

The price penalty is small enough that this is the better **snål men inte dumsnål** choice.

## Colour plan

The 6 × 1 kg format lets us buy something like:
- 4–5 kg main structural colour
- 1–2 kg accent colour

without sacrificing bulk economics.

Do not buy six novelty colours just because Mix & Match exists; most LR4 printed mass should ideally stay one predictable ordinary PLA batch/type.

## Absolute raw-price option — SUNLU 5 kg large spool

Current official SUNLU Europe-selectable listing has shown:
- ordinary PLA
- 5 kg single spool
- **€39.99** on a current selectable Europe listing
- free shipping advertised to most EU regions

Source:
- https://store.sunlu.com/sv-fr/products/5kg-large-spool-pla-abs-petg-and-pla-3d-printer-filament

Math:
- ~€8.00/kg
- ~89 SEK/kg at the same currency reference

This saves only about **€15** in material versus 6 × normal 1 kg spools at the current bulk tier.

### Why it is now option B, not option A

A 5 kg spool can require:
- a separate low-friction spool holder
- stronger support due to spool mass
- more awkward drying/storage
- one colour for the whole spool

For a user whose priority is getting the LowRider built and used rather than creating a filament-handling side project, saving ~€15 is not enough to make this the default.

Choose it only if:
- single colour is preferred
- printer/feed setup already handles a 5 kg spool comfortably, or
- building a simple external roller holder is desirable anyway

## Creality Soleyin Ultra — excellent alternative if combo is available

Current official Creality EU product page lists:
- Soleyin Ultra PLA
- 6 kg combo: **€59** / €9.83 per roll
- 8 kg: €79
- 10 kg: €89
- 12 kg: €99
- 20 kg: €164

But the 6 kg combo selector currently shows **Sold Out** on the exact product page, despite bulk-price cards being visible elsewhere on the EU store.

Sources:
- https://store.creality.com/eu/products/soleyin-ultra-pla-3d-printing-filament-1kg
- https://store.creality.com/eu/

### Decision

If 6 kg Soleyin returns to stock before ordering at €59 delivered-ish, it is a valid alternative to SUNLU.

SUNLU still wins slightly on current raw €/kg and has an explicitly useful Mix & Match structure.

## Rejected tempting option — matte PLA

SUNLU matte bulk is currently extremely cheap on some variants, around €9.99–11.99/kg and sometimes additional bulk discounts.

Do **not** select matte simply to shave a few euros.

Reason: LR4 wants conventional predictable stiff PLA; visual finish is secondary. Matte formulations can modify mechanical behaviour and provide no useful structural advantage here.

Use standard PLA unless a specific mechanical comparison proves otherwise.

## Amazon status

Previous targeted research found Amazon.se multipacks around roughly 137–143 SEK/kg, materially above the current direct SUNLU ~102 SEK/kg normal-spool route.

Prime remains a convenience fallback if a flash deal appears, not the default seller.

## Purchase recommendation

**Current first choice:**
- SUNLU ordinary PLA
- **6 × 1 kg**
- Europe shipment
- Mix & Match bulk tier
- target checkout around **€55–60 delivered / ~100–110 SEK/kg**

Suggested allocation:
- 4–5 rolls same main colour
- 1–2 rolls accent colour

**Second choice:**
- Creality Soleyin Ultra 6 kg for €59 if exact combo becomes available

**Absolute cheapest but less convenient:**
- SUNLU 5 kg giant spool around €39.99

## Checkout gates

Before payment confirm:
1. shipping destination is Sweden / Europe
2. product is **ordinary PLA**, not matte/silk/PLA+ by accidental variant selection
3. six-roll discount actually resolves to ~€9.19/kg class
4. shipping remains free/low to Sweden
5. chosen colours are all in stock

If checkout stays in the target range, no more PLA research is needed.
