kingkongola/lowrider/research/2026-08-29-final-nvr-estop.md

---
research_date: 2026-08-29
last_updated_at: 2026-08-29
scope: final Pareto machine mains switch / NVR / emergency-stop choice for LR4
status: recommendation-ready
confidence: high-on-device-class-medium-on-final-seller
machine_target: LowRider V4 ~650×1250, VEVOR 0700C 800 W, HDR-60-24 controller PSU, existing DeWalt DXV30SAPTA
region: Sweden / EU
price_basis: current EU and Swedish listings observed 2026-08-29; exact EU seller freight must be checked before order
sources_checked:
  - KEDU KJD12 manufacturer/order-option datasheet
  - Kahlhorn KEDU KJD12 technical sheet
  - Sinolec genuine KEDU KJD12/230V listing
  - Optimum/German KEDU KJD12 listings
  - Güde Denmark KJD12 listings
  - IKH Sweden KJD12 XW026-1 listing and Swedish shipping table
  - DXV30SAPTA original/manual copies including explicit 2450 W tool-socket rating
  - Swedish marketplace references used only as price comparison
supersedes:
  - earlier idea that a KJD17 remote-trip switch plus separate contactor/mushroom is the default Pareto architecture
---

# Final NVR / emergency-stop direction

## Decision

Use a **genuine KEDU KJD12, 230 V, 16 A, 4-pin/2-pole NVR machine switch with the yellow/red emergency-stop cover/button** as the preferred baseline machine mains switch.

If genuine-KEDU EU freight is poor, **IKH Sweden `XW026-1`** is now a credible domestic fallback: it is explicitly sold as `KJD12 10/16A 57X35` / emergency-stop switch, but the IKH product page does not explicitly state KEDU as manufacturer.

This is dramatically simpler than building an industrial contactor/control circuit while still providing the two practical behaviours we actually need:
- **no-volt release / restart prevention** after mains loss
- a large, easy-to-hit stop actuator that removes mains power through the two-pole switch

This is a hobby/workshop CNC machine-power solution. Do not describe it as a safety-PLC / PLd / Category-3 safety system.

## Exact electrical class

KEDU KJD12 manufacturer/reference data supports:
- 230 V / 50 Hz coil variant
- 2-pole N/O switching
- 16 A AC-1 at 230 V
- 10 A AC-3 at 230 V on the Kahlhorn reference
- IP54 front
- 6.3×0.8 mm Faston terminals
- no-voltage release
- optional emergency-stop button/cover in the KEDU order system

Sources:
- https://www.kahlhorn.com/print_product_info/english/kjd12.pdf
- https://www.stathisnet.gr/image/SpecsUpload/016325.pdf

Sinolec's genuine KEDU `KJD12/230V` is specifically described as:
- DPST
- 16(12) A / 250 V
- 220–250 V AC
- red/green actuators plus red emergency-stop button under yellow top
- IP54
- TUV / VDE / CE / UL approvals

Source:
- https://sinolec.co.uk/gb/nvr-no-volt-release-kedu-switches/1212072-kjd12230v-nvr-emergency-safety-stop-switch-230v-16a.html

## Load margin for our machine

Core nominal cutting loads:
- DeWalt DXV30SAPTA: 1050 W
- VEVOR router: ~800 W
- HDR-60-24: roughly <=70 W mains input class at full load

Combined nominal power is around **1.9 kW**, approximately **8.3 A at 230 V** before motor starting transients.

That remains inside the KJD12's 16 A AC-1 / 10 A AC-3 reference class. Final wiring, connectors, enclosure and upstream circuit protection must still be appropriately rated.

## DeWalt auto-start topology is now verified

The previous open question was whether the existing DeWalt DXV30SAPTA tool socket could safely supply the 800 W router.

A DXV30SAPTA manual distributed by jem & fix explicitly gives:
- **maximum connected electric-tool power: 2450 W**

The VEVOR 0700C is only 800 W, about one third of that rating.

The DeWalt manual also verifies:
- automatic vacuum start/stop from the connected tool
- approximately 15 seconds run-on after the tool is switched off

Sources:
- https://media.jemogfix.dk/prod-mediafiles/dk/pdf/1140_9077574_001.pdf
- https://www.bauhaus.se/media/pdf/1163387A.pdf
- https://www.manualslib.com/manual/3147173/Dewalt-Dxv30sapta.html?page=22

### Locked baseline mains topology

```text
wall
  |
  v
KJD12 NVR / emergency stop
  |
  +----> HDR-60-24 ----> Jackpot3
  |
  +----> DeWalt DXV30SAPTA [AUTO mode]
                       |
                       +---- 230 V tool socket ----> VEVOR 0700C
```

Benefits:
- one machine-level KJD12 stop removes mains from controller, vacuum and router
- DeWalt provides the router-triggered vacuum start automatically
- vacuum continues ~15 s after normal router shutdown
- KJD12 no-volt release prevents automatic machine restart after supply loss
- no separate vacuum-trigger relay/smart switch is needed

Physical unit label/socket rating should still be inspected during commissioning; if the actual machine is marked with a lower tool-socket limit, the physical marking wins over the generic manual.

Detailed DeWalt research:
- `research/2026-08-29-dewalt-tool-socket.md`

## Current purchase references

### Preferred: genuine KEDU from EU/UK seller when delivered price is sensible

Sinolec current exact unit:
- brand: **KEDU**
- reference `KJD12/230V`
- DPST
- 16(12) A / 250 V
- emergency stop + NVR
- IP54
- CE/TUV/VDE/UL
- current item price £17.94 incl UK VAT display
- current stock roughly 97–104 units depending crawl

European shipping table from Sinolec:
- under £30 order: **£7.50** shipping
- taxes/duties may be payable on receipt because shipment is from UK

Sources:
- https://sinolec.co.uk/gb/nvr-no-volt-release-kedu-switches/1212072-kjd12230v-nvr-emergency-safety-stop-switch-230v-16a.html
- https://sinolec.co.uk/gb/content/1-delivery

The product itself is cheap; Brexit VAT/import administration can make the delivered total less attractive than a Swedish/EU source.

### Exact German reference

Optimum / Stürmer spare part:
- code **`ST0380001`** / manufacturer reference `0380001`
- KEDU KJD12
- 230 V
- 16 A
- IP54
- 4-pole terminal arrangement / 2 switched poles
- **includes yellow cover with emergency-stop button**
- current observed item price **€28.86 incl VAT**

Source:
- https://drehen-fraesen-bohren.de/stuermer-maschinen-optimum-aircraft-metallkraft/ersatzteile/elektrobauteile/ohne-unterwarengruppe/schalter-230v-kedu-kjd12-16a-ip54-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

Other German exact references:
- Optimum/Bach `0380001`: ~€39.09, also explicitly includes Not-Aus cover
- ManoMano Germany genuine KEDU/Güde variants around ~€18–45 depending seller/variant

Sources:
- https://www.bachgmbh.de/Schalter-230V-KEDU-KJD12-16A-IP54-4POL-0380001
- https://www.manomano.de/p/kedu-kjd12-magnetschalter-4pin-startstop-250v-16a-mit-not-aus-funktion-druckknopfschalter-62632844

### Swedish fallback: IKH `XW026-1`

IKH Sweden currently lists:
- item `XW026-1`
- description: **KJD12 10/16A 57×35** / emergency-stop switch
- price observed **357 SEK incl VAT** on the exact product page; category crawl has shown 363 SEK, so product page/checkout wins
- item available in webstore
- EAN `6418914846562`
- gross weight ~0.147 kg

Source:
- https://www.ikh.se/en/emergency-stop-switch-for-kjd12-57x35-xw026-1

IKH Sweden shipping:
- PostNord service point from **125 SEK**
- home delivery from 210 SEK
- final price shown in cart

Source:
- https://www.ikh.se/sv/kundtjanst/leveranssatt

Indicative service-point delivered total:
- 357 + 125 = **~482 SEK**

This is inside our accepted 400–500 SEK band and buys Swedish storefront/return handling.

Caveat: IKH's page says KJD12 but does **not explicitly identify the manufacturer as KEDU**. Therefore it is a domestic fallback, not evidence-equivalent to the explicitly branded Sinolec/Optimum options.

### Denmark

Güde Denmark sells KJD12 variants for **205 DKK** and shows stock on current pages.

However KJD12 has several mechanical design variants. A Denmark listing is only valid if the chosen version visibly includes the emergency-stop actuator/cover we want.

Sources:
- https://www.guede.dk/kontakt-onoff-kjd12-p-2439.html?language=en
- https://www.guede.dk/startstop-switch-kedu-kjd12-design-p-2420.html?language=en

## Why not Swedish Fyndiq/Fruugo generics

Current Swedish marketplace pages show KJD12/KJD12-14 products around ~214–338 SEK plus small freight, but manufacturer identity and exact emergency-stop mechanics are often unclear/unbranded.

For a mains safety switch, saving perhaps 50–100 SEK is not worth losing provenance.

Use those only as a price reference, not the default purchase source.

## Why not KJD17 + separate contactor anymore

A KJD17 remote-trip input is useful for industrial interlocks, but it created unnecessary design questions about:
- how remote trip is wired
- whether the mushroom only drops a coil
- whether a contactor is then needed for robust upstream isolation
- extra enclosure, terminals and mains wiring

The genuine KJD12 integrated machine-switch form already provides the practical stop + NVR behaviour for this small machine with far fewer components.

If the project later needs door interlocks, safety relays, automatic spindle control or industrial safety categories, revisit the architecture then.

## Enclosure / wiring architecture

Do not leave mains terminals exposed.

Implementation:
- mount KJD12 in a small robust insulated or earthed enclosure/front panel
- use a properly rated two-outlet machine distribution after the switch: one for DeWalt, one for HDR-60-24 supply/enclosure
- strain relief on mains entry/exit
- use correctly rated flexible cable and insulated 6.3 mm female Faston terminals or equivalent approved terminations
- protective earth bypasses the switch and remains continuous to all Class-I loads/enclosures
- switch both live and neutral through the two KJD12 poles where the actual wiring diagram/terminal markings specify the DPST arrangement
- do not rely on wire colours; follow terminal numbering/data sheet

The KJD12 does **not** provide overload/short-circuit protection. House circuit protection and any machine-specific fuse/breaker remain separate functions.

## Buy threshold

For a **genuine branded KEDU KJD12 with emergency-stop cover**, accept roughly:
- **<=400 SEK delivered:** excellent, buy
- **400–500 SEK delivered:** still reasonable if seller is reputable and exact variant is clear
- **>500 SEK delivered:** re-compare EU sellers / IKH fallback

For the non-manufacturer-explicit IKH fallback, ~482 SEK delivered is acceptable because Swedish return/support reduces transaction risk, but an explicitly genuine KEDU at the same all-in price wins.

## Remaining pre-order check

1. Check exact Optimum/Sinolec/genuine-KEDU Sweden delivered total.
2. If a genuine KEDU lands <=500 SEK, choose it.
3. If genuine EU/UK shipping/import pushes total clearly above ~500 SEK, use IKH Sweden `XW026-1` around ~482 SEK service-point delivered, after confirming the product image/marking and 230 V terminal arrangement.

No separate router/vacuum auto-start hardware is required.
