kingkongola/lowrider/research/2026-08-29-vevor-0700c-router.md

---
research_date: 2026-08-29
last_updated_at: 2026-08-29
scope: exact VEVOR router variant for LR4, compatibility with already-purchased Elaire 1/8 collet, and current EU/Sweden purchase economics
status: purchase-ready
confidence: high
machine_target: LowRider V4 ~650×1250 mm usable area
region: Sweden / VEVOR EU
price_basis: official VEVOR EU product page observed 2026-08-29; Sweden destination may adjust VAT at checkout; shipping policy currently gives Sweden standard free shipping
observed_price:
  currency: EUR
  amount: 83.99
  approximate_SEK_at_2026_08_29_reference_fx: 934.59
shipping: current VEVOR EU policy says all products free shipping except listed countries/remote cases; Sweden is not listed as a surcharge country
sources_checked:
  - VEVOR EU exact product page
  - VEVOR EU shipping policy
  - VEVOR EU VAT statement/Q&A
  - VEVOR 0700C official Q&A/manual
  - Elaire official Makita collet catalog
  - HaWiWe exact purchased collet page
  - V1 Engineering forum real VEVOR 0700C collet use
supersedes: earlier price-unknown state in this file and any earlier 710 W VEVOR router candidate
---

# VEVOR 0700C — purchase-ready router

## Exact identity — do not substitute

Lock all of these identifiers:
- model: **VEVOR `0700C`**
- VEVOR SKU: **`YXKXBJ710W65AH7WLV2`**
- VEVOR product/page ID: **`010235793217`**
- rated voltage: **220–240 V / 50 Hz**
- rated power: **800 W / 1.25 hp**
- speed: **10,000–30,000 rpm**
- six speed settings
- router body diameter: **65 mm**

Official product page:
https://eur.vevor.com/compact-router-c_10131/vevor-wood-router-1-25hp-800w-compact-wood-trimmer-router-combo-tool-with-plunge-and-fixed-base-30000rpm-6-variable-spee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

## Current live price

Official VEVOR EU page observed 2026-08-29:
- **€83.99**
- listed in stock
- page shows SKU `YXKXBJ710W65AH7WLV2`
- page resolves to exact model 0700C / 800 W

Reference FX observed same date:
- €83.99 ≈ **934.59 SEK**

Treat EUR price as authoritative and SEK conversion as a planning reference only.

## Shipping to Sweden

VEVOR EU current shipping policy states:
- products are currently free shipping except specified countries/remote/heavy cases
- Sweden is **not** among the listed EU surcharge countries
- normal delivery reference is 2–6 business days plus processing

Source:
https://eur.vevor.com/pages/shipping-policy

The 0700C is only ~1.81 kg net and is not a heavy/oversize item.

**Expected Sweden shipping: €0**, but final checkout remains authoritative.

## VAT / customs

VEVOR's European site states product prices include VAT, with final VAT recalculated according to destination-country rate at checkout.

This is an EU-store purchase route, and VEVOR Q&A states EU-region products are shipped from EU countries for EU destinations. The practical expectation is therefore no separate Swedish import/customs handling on this router.

Final Sweden checkout should still be checked for:
- destination VAT adjustment
- coupon/app discount
- shipping staying €0

## Why this beats router alternatives for this build

The already-purchased €29 Elaire 1/8 in collet makes Makita-0700 compatibility important.

This exact VEVOR is unusually well supported:
- VEVOR explicitly says Makita 0700 base compatibility
- exact body diameter is 65 mm
- V1E users identify it as a Makita 700 clone
- a real V1E user has successfully run a Makita-style 1/8 collet in the VEVOR 0700C original nut with low visible runout

This makes it a much lower-risk cheap-router choice than an arbitrary 65 mm trimmer.

## Already-purchased collet

HaWiWe/Elaire item:
- Elaire `MRP-1250`
- Makita-style 1/8 in / 3.175 mm
- purchased for €29 in the paid HaWiWe order

Elaire lists this family for Makita RT700C / RT0700CX3 / RT0701C and related routers.

Sources:
- https://elairecorp.com/makitaroutercollets.html
- https://elairecorp.com/product/mrp-1250/

## Compatibility confidence

No manufacturer document literally certifies `MRP-1250 + VEVOR 0700C`.

Evidence chain:
1. exact VEVOR says Makita 0700-base compatible
2. 65 mm body is correct
3. Elaire collet is Makita 0700-family
4. exact VEVOR 0700C has proven real-world use with another Makita-style 1/8 collet in original nut

Assessment: **high confidence**, but physical test before cutting remains mandatory.

## Arrival test

Before CNC use:
1. unplug router
2. clean taper, nut and collet
3. verify MRP-1250 seats naturally
4. install a straight 1/8 in cutter at correct insertion depth
5. hand rotate / visually inspect
6. run low speed
7. ideally measure runout with dial indicator
8. stop rather than forcing the collet if seating is wrong

## Purchase rule

This item is now **purchase-ready**.

At checkout, verify:
- product ID `010235793217`
- SKU `YXKXBJ710W65AH7WLV2`
- model `0700C`
- 800 W
- 220–240 V / 50 Hz
- 65 mm
- €83.99-class price or better
- free Sweden shipping

Do not accidentally switch to the stale 710 W VEVOR variant.
