kingkongola/lowrider/research/2026-08-29-gt2-drive.md

# Research: GT2 drive — 2026-08-29

Scope intentionally limited to:
- 3 × 16T drive pulleys
- 6 × smooth idlers
- 10 mm GT2 belt

## LR4 requirements

Verified against current V1E LR4 documentation:
- 3 × 16T GT2 drive pulleys
- for 10 mm belt
- 5 mm motor bore
- 6 × smooth 20T-size idlers
- 5 mm bearing bore
- for 10 mm belt
- GT2 10 mm belt
- fiberglass / non-steel reinforcement

Source:
- https://docs.v1e.com/lowrider/

## Belt length for current 650 × 1250 mm target

Using V1E's current calculator formula:
- `xstrut = ceil(xUsable + 169)`
- `xbelt = xstrut + 180`
- `yrail = yUsable + 255`
- `ybelt = yrail + 200`
- total belt = `xbelt + 2 * ybelt`

For 650 × 1250 mm usable area:
- X belt = 999 mm
- each Y belt = 1705 mm
- total = **4409 mm**

Therefore a **single 5 m roll is enough**, leaving ~591 mm spare. This is materially better than blindly buying the generic ~8 m quantity often listed in the LR4 BOM.

Source:
- https://raw.githubusercontent.com/V1EngineeringInc/V1EngineeringInc-Docs/master/docs/lowrider/calculator.js

## Best verified idler + belt cart so far: LaskaKit

### Smooth idlers

POWGE `LA190008E`
- smooth
- for 10 mm GT2 belt
- 5 mm bearing bore
- ~€1.87 incl VAT each
- 6 required = ~€11.22

Source:
- https://www.laskakit.cz/en/powge/

### Belt

LaskaKit `LA190013C`
- GT2
- 10 mm width
- fiberglass reinforced
- 5 m
- ~€7.81 incl VAT

Source:
- https://www.laskakit.cz/en/3d-printing-cnc-machines/

### Shipping to Sweden

LaskaKit lists GLS Sweden at **€8.93**.

Current GT2 partial-cart math:
- 6 idlers: ~€11.22
- 5 m belt: ~€7.81
- Sweden shipping: €8.93
- subtotal delivered: **~€27.96**

This shipping becomes much more attractive if later commodity parts can be added to the same order.

Important: LaskaKit currently has a 16T/5 mm POWGE pulley only for **6 mm belt**, which is wrong for LR4. Do not substitute it just to consolidate the cart.

Source:
- https://www.laskakit.cz/en/shipping-and-payment/

## 16T drive pulleys — exact verified options

### Hellas Digital

Product `070.0051`
- GT2
- 16T
- 5 mm bore
- 10 mm belt width
- ~€1.61 incl VAT each
- listed in stock

3 pcs parts cost only ~€4.83, but Sweden shipping has not yet been verified. A separate order may therefore be irrational despite the low item price.

Source:
- https://www.hellasdigital.gr/go-create/3d-printing/accessories/gt2-16t-bore-5mm-width-10mm-pulley/

### Anodas

Product `AN-18925`
- GT2
- 16T
- 5 mm bore
- compatible with 10 mm belt
- €3.00 each

Technically correct, but delivery economics to Sweden still need checking.

Source:
- https://www.anodas.lt/en/16t-sprocket-for-gt2-10mm-belt-5mm-bore

### Allegro Poland

Product code `GT2-16T-5B_10mm_K`
- GT2
- 16T
- 10 mm belt
- 5 mm bore
- 2 locking grub screws
- 7.20 PLN each on observed listing

Again, final Sweden shipping / seller cart economics need checking before recommendation.

## Amazon / Prime result

No indexed Amazon.se listing was found that could be verified end-to-end as the exact LR4 combination:
- 16T
- 5 mm bore
- 10 mm belt
- plus correct smooth 5 mm-bore idlers
- plus fiberglass 10 mm belt

Therefore do **not** buy an Amazon bundle merely because its title says GT2. The most common traps are 6 mm belt variants, toothed 20T idlers instead of smooth idlers, and wrong bore sizes.

If a specific Amazon listing is found manually in the app, verify the selected variant against these invariants before ordering.

## Current conclusion

Do not place a GT2-only order yet.

Best current structure:
1. Treat **5 m** as sufficient belt quantity for the current 650 × 1250 mm machine.
2. Keep LaskaKit as the strongest candidate for **6 smooth idlers + 5 m fiberglass belt**.
3. Do not accept LaskaKit's 6 mm-width 16T pulley.
4. Keep Hellas / Anodas / Allegro as exact 16T candidates.
5. Before buying, continue commodity-cart research because LaskaKit also stocks other relevant mechanical parts. Spreading the €8.93 Sweden shipping over T8/couplers/endstops or other correct parts may make it the best total cart.

The goal remains lowest correct delivered total, not fewest supplier names at any cost.
