kingkongola/lowrider/machine/delar/1033926-makita-701-autospin-t1-tool-mount-and-dust-shoe-for-the-lowrider-4-cnc-177ebeaa-a77d-43f3-adcd-c02e32465eba.pdf

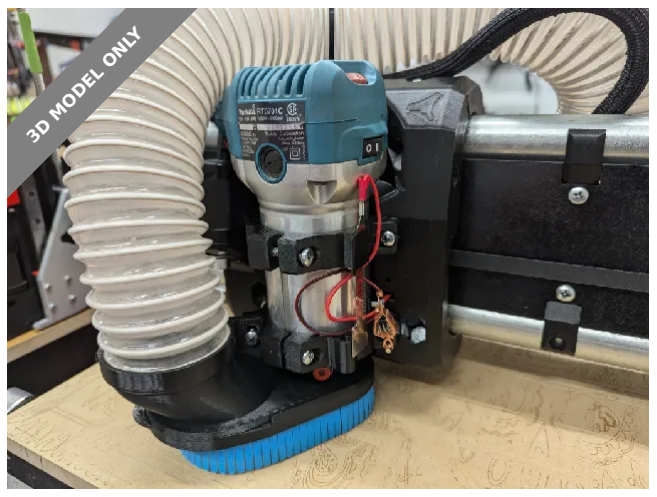
[picture p2: figure]
3D MODEL ONLY

## Summary

Tool mount and dust shoe for the Makita 700 or AutoSpin T1 series palm router and a 70mm OD or less vac hose.

Hobby & Makers (https://printables.com/model?categoryId=48) > Mechanical Parts (https://printables.com/model?categoryId=51)

Tags: | lowrider | lowridercnc | v1engineering | v1e | lr4
lowrider4

Tool mount and dust shoe for the Makita 700 series palm router or the Sienci AutoSpin T1 and a 70mm OD or less vac hose.

PETG or better if you are concerned with heat. PLA works for most routers, some new ones seem to be hotter than the old ones though.

Best to print both parts at the same time to assure a good fit, they easily fit on a 200x200 bed.

Use 2 walls or fewer so the overhangs print right.

V1 Engineering (https://printables.com/@V1Engineering)

## Makita 701 / AutoSpin T1 Tool Mount and Dust Shoe for the LowRider 4 CNC

VIEW IN BROWSER (https://printables.com/model/1033926-makita-701-autospin-t1-tool-mount-and-dust-shoe-fo)

updated 18. 3. 2026 | published 18. 3. 2026

## Model files

The TPU part is best near a 0.35mm layer height, one wall. 95a durometer works great.

The TPU bristles are available for purchase (https://www.v1e.com/products/tpu-bristles-for-the-lr4-dust-shoes) if you do not want to get a whole roll for such a small print.

V1 - Top tool mount edit to better fight ESD / static on the touch probe mount.

*** Cura users, Cura does not seem to play nice so make sure the overhangs on the small part look okay before printing.

dust_skirt_makita.stl

dust_shoe_makita.stl

tool-mount-b_makita.stl

tpu-bristles-22mm.stl

tpu-bristles-32mm-extra-long.stl

makita-dust_shoe.step

makita-dust_skirt.step

## License

This work is licensed under a
Creative Commons (4.0 International License)

Attribution—Noncommercial—Share Alike (http://creativecommons.org/licenses/by-nc-sa/4.0/)

✖ | Sharing without ATTRIBUTION
✔ | Remix Culture allowed
✖ | Commercial Use
✖ | Free Cultural Works
✖ | Meets Open Definition

makita-step.step

tool-mount-t-v1-makita.stl
