kingkongola/lowrider/machine/delar/nollpunkt/fallarm_C_sladd.png

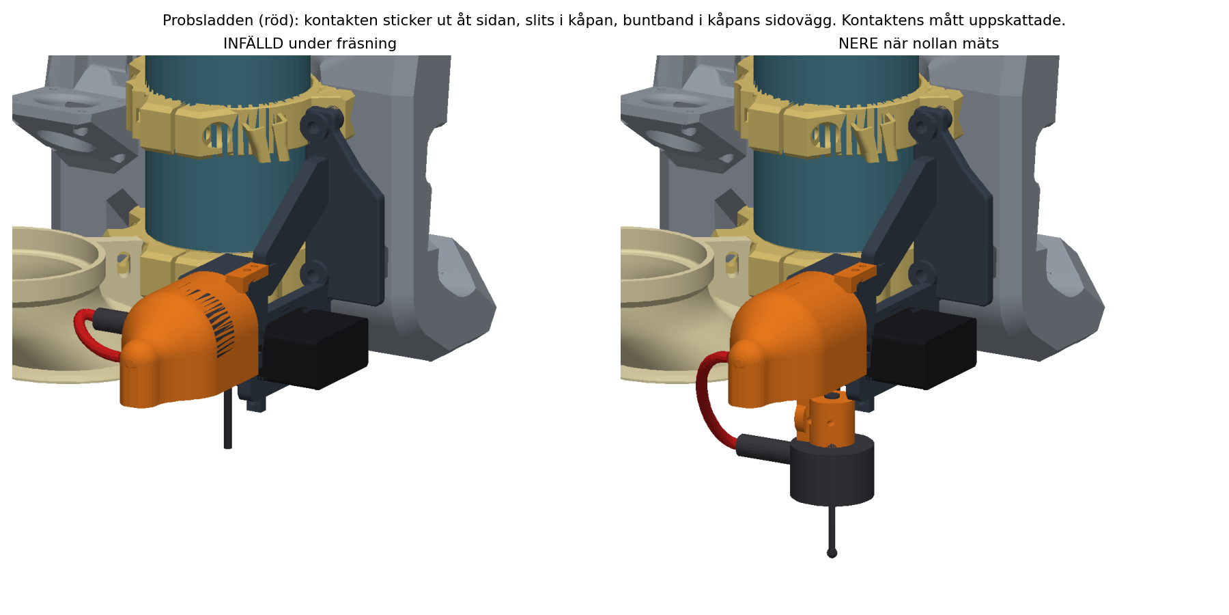
machine/delar/nollpunkt/fallarm_C_sladd.png
