kingkongola/lowrider/machine/taster/taster.png

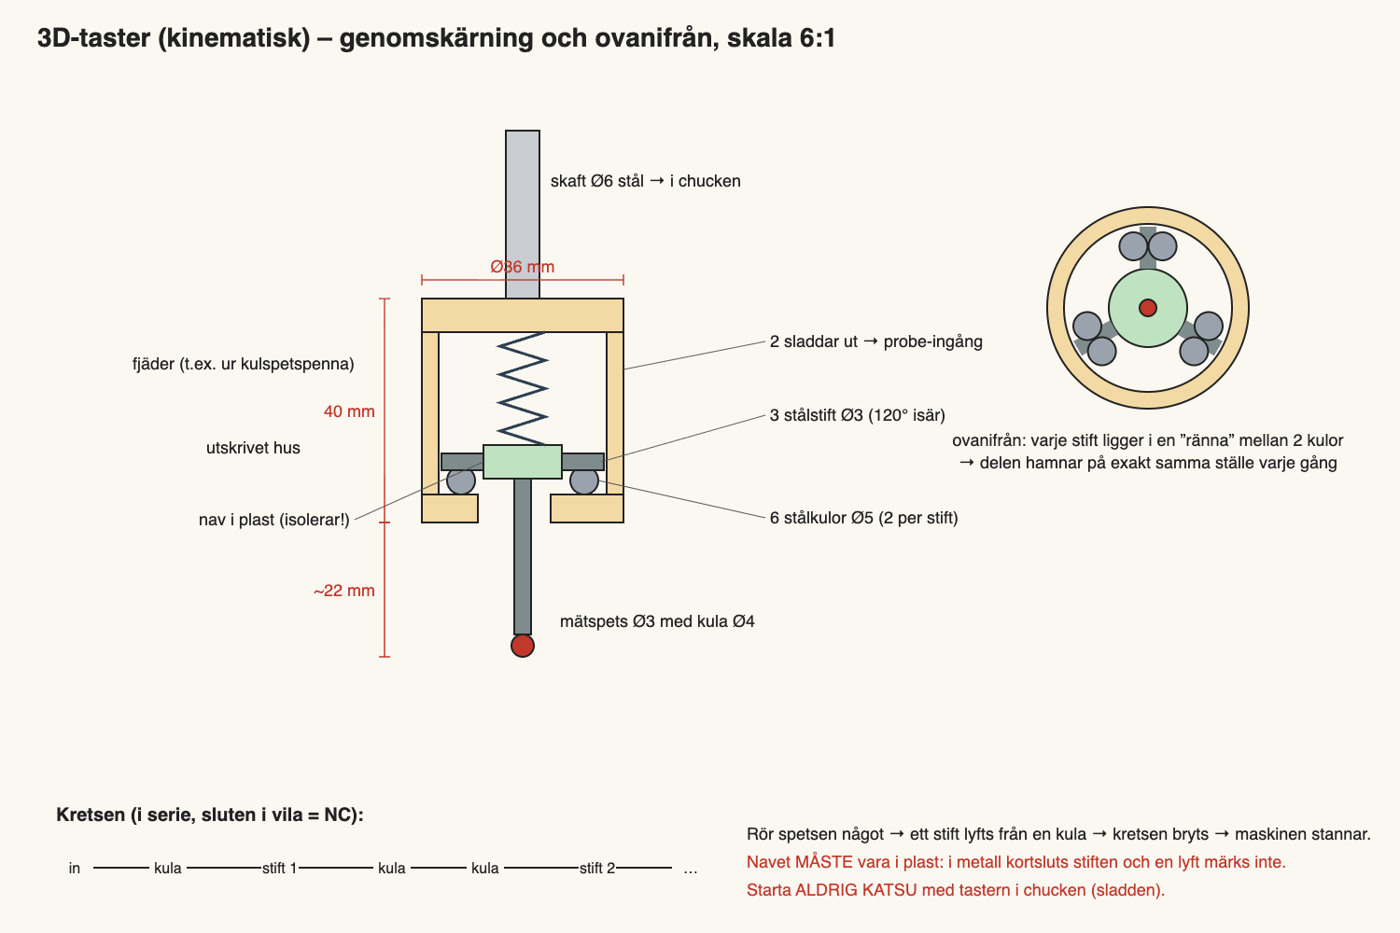
machine/taster/taster.png
