kingkongola/lowrider/machine/delar/nollpunkt/attrapp.printa/prob_attrapp.3mf

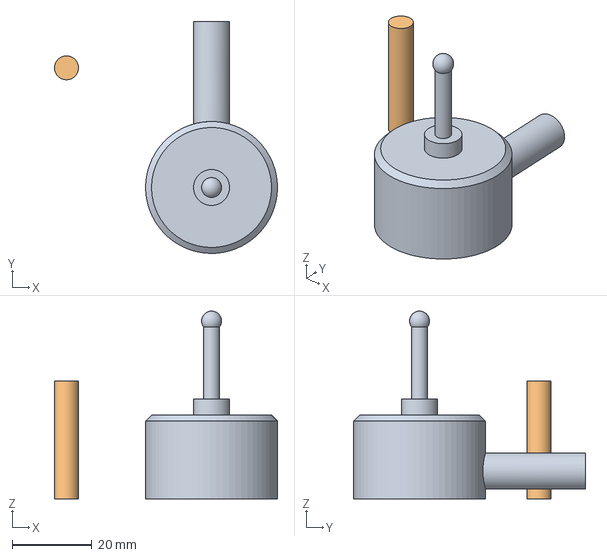
[picture p5: CAD file, 2026-11-05]
machine/delar/nollpunkt/attrapp.printa/prob_attrapp.3mf
55.8 x 58.0 x 47.0 mm
attrapp_kropp.stl
attrapp_skaft.stl
