kingkongola/lowrider/machine/delar/nollpunkt/fallarm_C.printa/fallarm_C.3mf

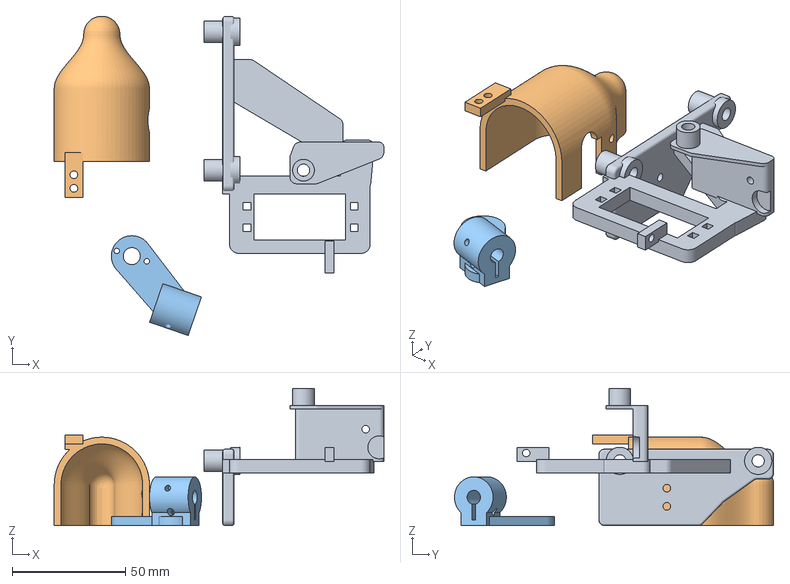
[picture p6: CAD file, 2026-11-05]
machine/delar/nollpunkt/fallarm_C.printa/fallarm_C.3mf
145.3 x 140.6 x 60.5 mm
print_C_faste.stl
print_C_kapa.stl
print_C_arm.stl
