kingkongola/lowrider/machine/delar/nollpunkt/fallarm_stag.step

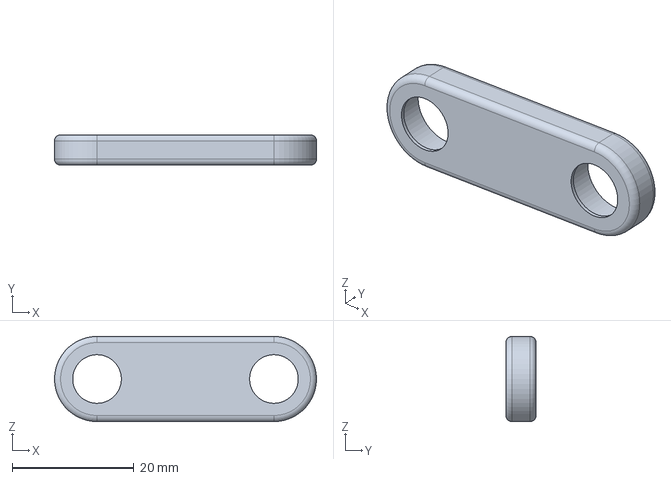
[picture p7: CAD file, 2026-11-05]
machine/delar/nollpunkt/fallarm_stag.step
43.1 x 5.00 x 14.0 mm
