kingkongola/lowrider/machine/delar/nollpunkt/provarm.printa/provarm.3mf

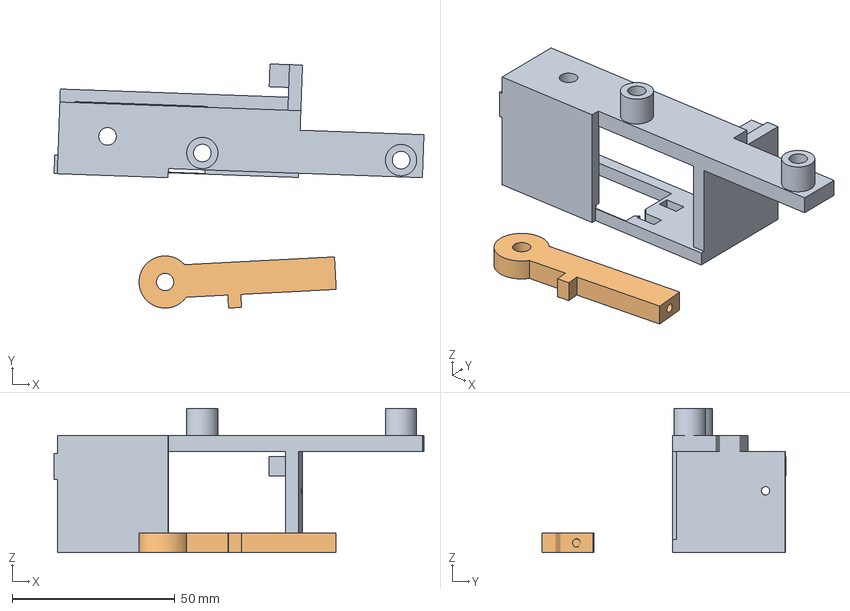
[picture p8: CAD file, 2026-11-05]
machine/delar/nollpunkt/provarm.printa/provarm.3mf
113.5 x 74.9 x 44.3 mm
print_faste.stl
print_arm.stl
