kingkongola/lowrider/machine/delar/plintkapa.stl

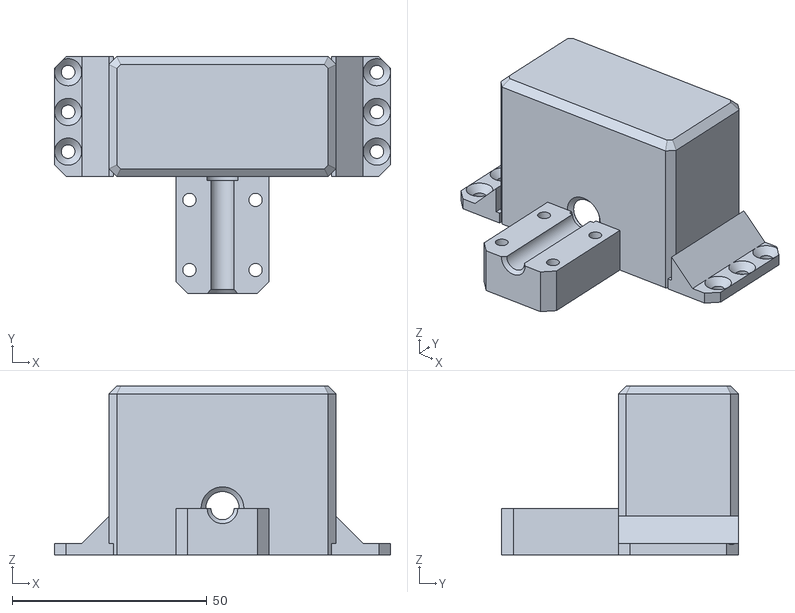
[picture p9: CAD file, 2026-10-22]
machine/delar/plintkapa.stl
86.3 x 60.8 x 43.4
