kingkongola/lowrider/Piatto_Componenti.3mf

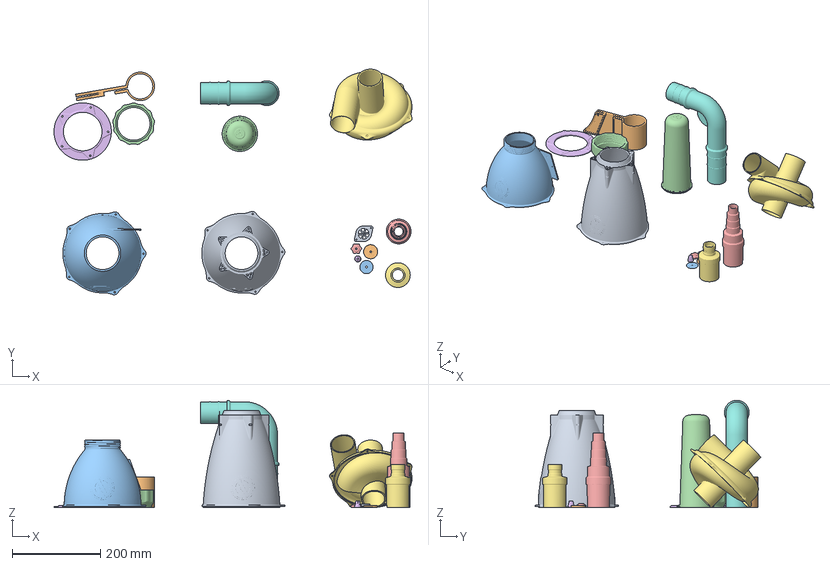
[picture p10: CAD file, 2026-10-22]
Piatto_Componenti.3mf
811.3 x 511.6 x 243.5 mm
C1_2.STL
Coupling.STL
C2_1.STL
C2_2.STL
Add_1.STL
C1_3.STL
Add_2.STL
A_1.STL
Vac_1.STL
Vac_2.STL
Vgo_1.STL
goblet.STL
Vgo_2.STL
Vac_3.STL
C.STL
