kingkongola/lowrider/Cyclone_separator.3mf

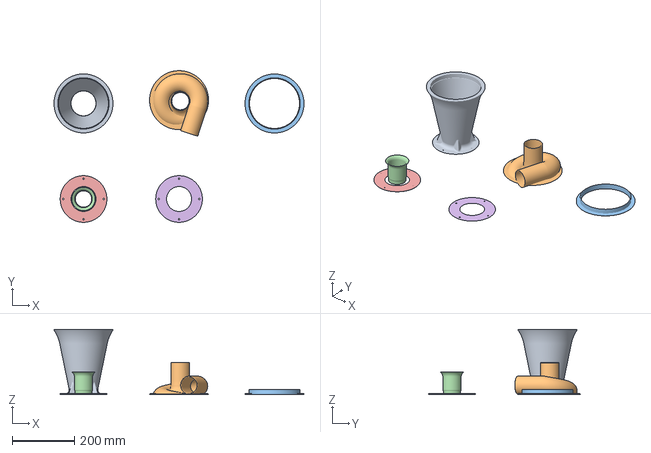
[picture p11: CAD file, 2026-10-22]
Cyclone_separator.3mf
803.5 x 487.4 x 209.0 mm
