kingkongola/lowrider/machine/delar/nollpunkt/fallarm_stag_B_alu.step

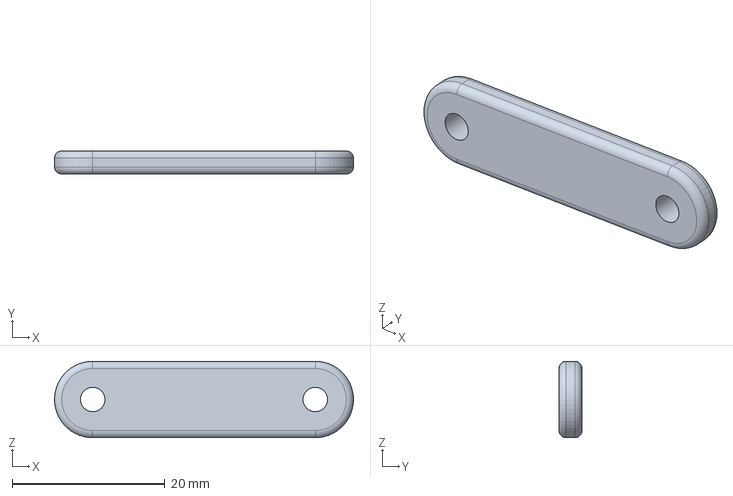
[picture p12: CAD file, 2026-11-05]
machine/delar/nollpunkt/fallarm_stag_B_alu.step
39.1 x 3.00 x 10.0 mm
