kingkongola/lowrider/machine/delar/tpu-bristles-22mm.stl

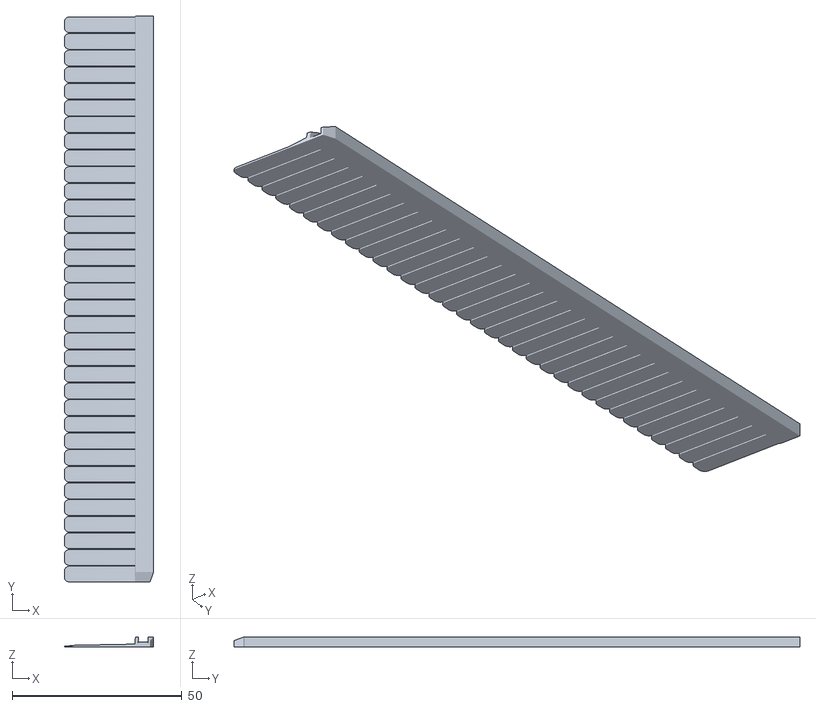
[picture p13: CAD file, 2026-10-22]
machine/delar/tpu-bristles-22mm.stl
26.3 x 166.5 x 3.02
