kingkongola/lowrider/machine/delar/nollpunkt/fallarm_C_faste.step

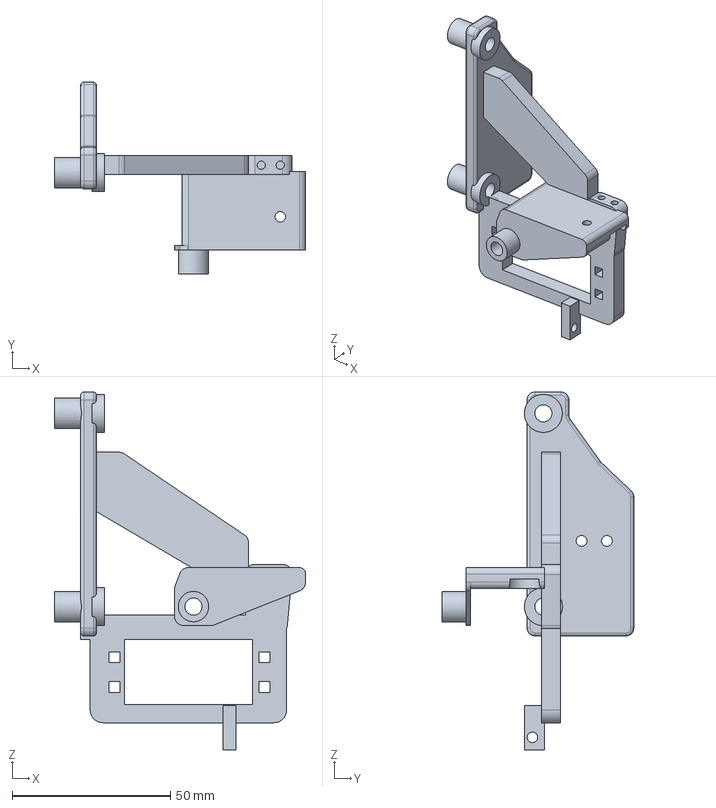
[picture p14: CAD file, 2026-11-05]
machine/delar/nollpunkt/fallarm_C_faste.step
79.3 x 60.5 x 113.0 mm
