kingkongola/lowrider/machine/delar/tool-mount-t-v1-makita.stl

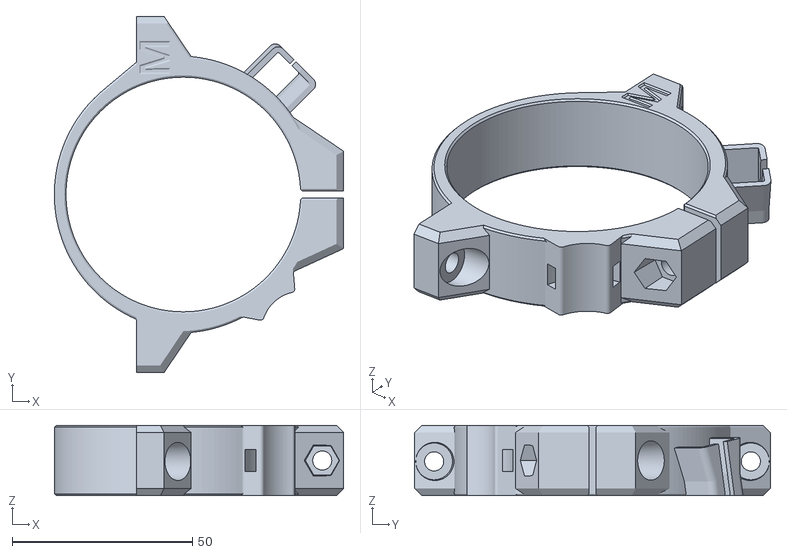
[picture p15: CAD file, 2026-10-22]
machine/delar/tool-mount-t-v1-makita.stl
80.3 x 98.8 x 19.5
