kingkongola/lowrider/Zyklon.3mf

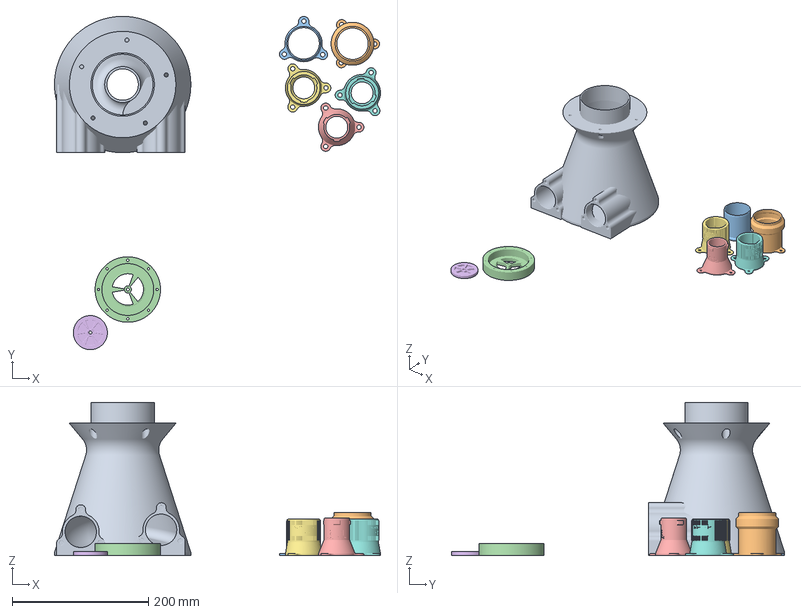
[picture p16: CAD file, 2026-10-22]
Zyklon.3mf
478.3 x 489.0 x 225.0 mm
Zyklon v3.step
Muffe 50.stl
Stutzen 50.step
Adapter.step
Osvac Neo M32.step
Platte.step
Osvac Neo F32 ohne Dichtung.stl
Osvac Neo F32 mit Dichtung.stl
