kingkongola/lowrider/ciclone_separatore.3mf

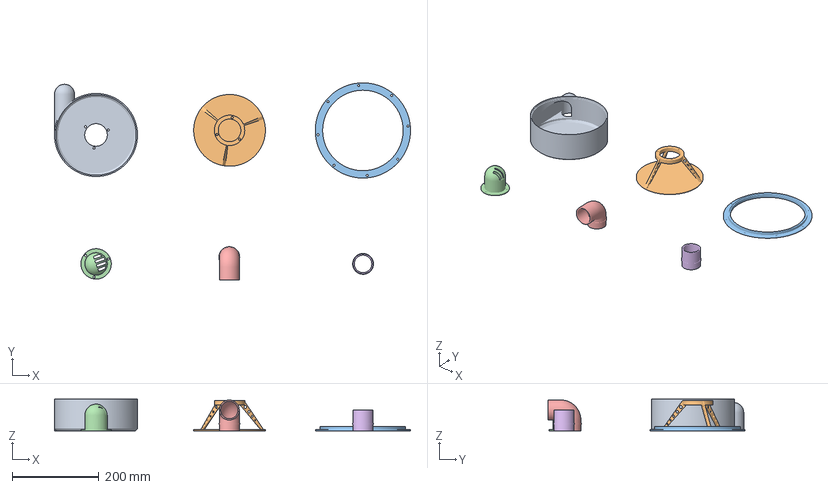
[picture p17: CAD file, 2026-10-22]
ciclone_separatore.3mf
819.0 x 453.9 x 73.0 mm
disk
ring
internal connector
90 degree connector
right connector
