kingkongola/lowrider/machine/delar/nollpunkt/print_faste.stl

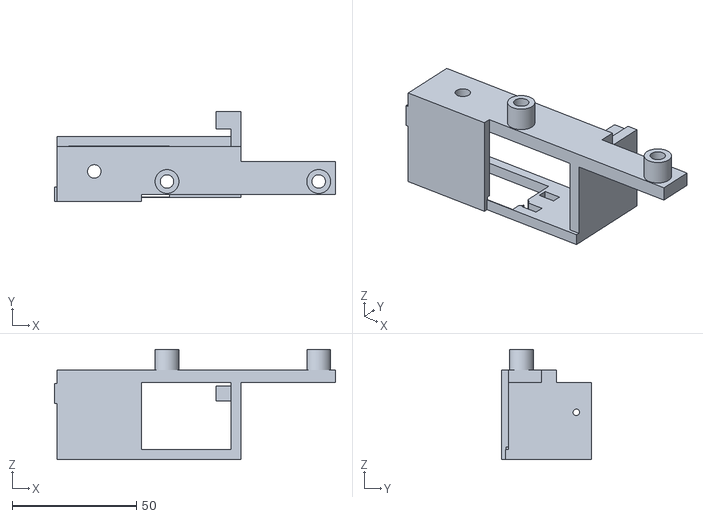
[picture p18: CAD file, 2026-11-05]
machine/delar/nollpunkt/print_faste.stl
113.0 x 36.0 x 44.3
