kingkongola/lowrider/machine/delar/slangadapter_46mm.stl

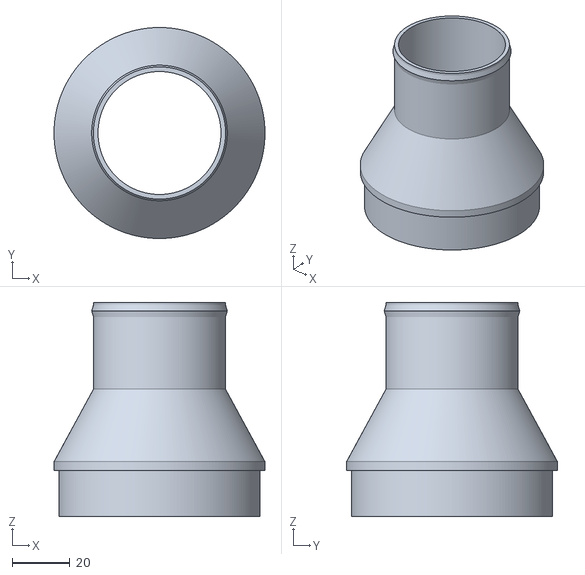
[picture p19: CAD file, 2026-10-22]
machine/delar/slangadapter_46mm.stl
72.8 x 72.8 x 74.0
