kingkongola/lowrider/machine/delar/nollpunkt/fallarm_faste.step

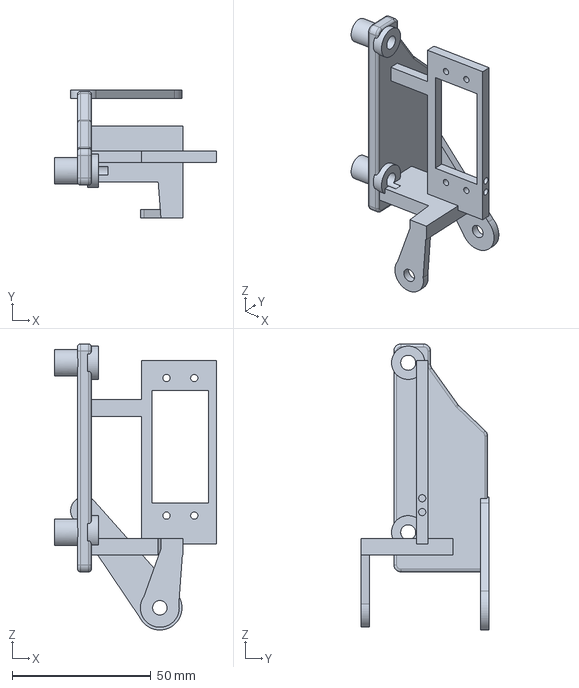
[picture p20: CAD file, 2026-11-05]
machine/delar/nollpunkt/fallarm_faste.step
58.3 x 46.0 x 102.9 mm
