kingkongola/lowrider/machine/delar/slangadapter_46mm_upp-och-ned.stl

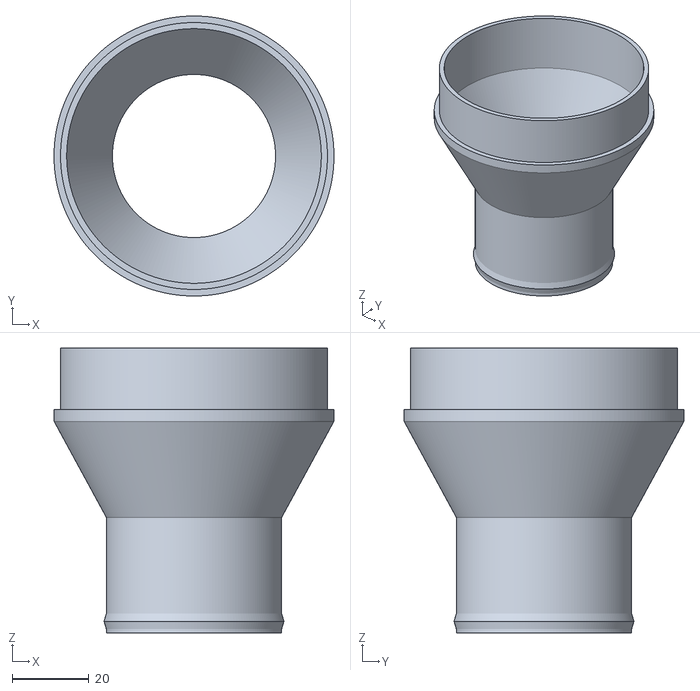
[picture p21: CAD file, 2026-10-22]
machine/delar/slangadapter_46mm_upp-och-ned.stl
72.8 x 72.8 x 74.0
