kingkongola/lowrider/machine/delar/dust_skirt_makita.stl

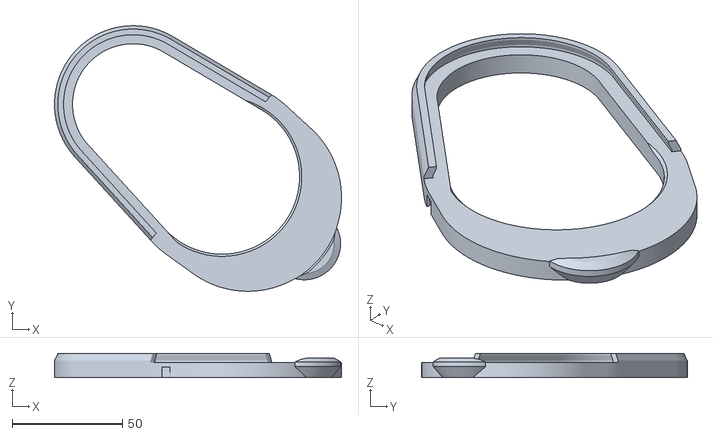
[picture p22: CAD file, 2026-10-22]
machine/delar/dust_skirt_makita.stl
130.3 x 120.6 x 11.0
