kingkongola/lowrider/machine/delar/nollpunkt/fallarm_C_kapa.step

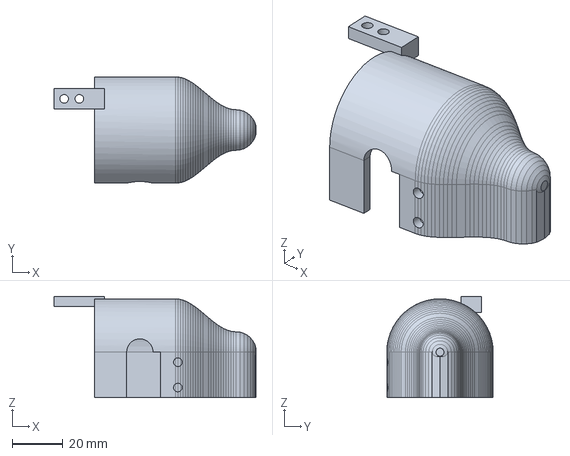
[picture p23: CAD file, 2026-11-05]
machine/delar/nollpunkt/fallarm_C_kapa.step
79.7 x 42.0 x 40.0 mm
