kingkongola/lowrider/machine/delar/dust_shoe_makita.stl

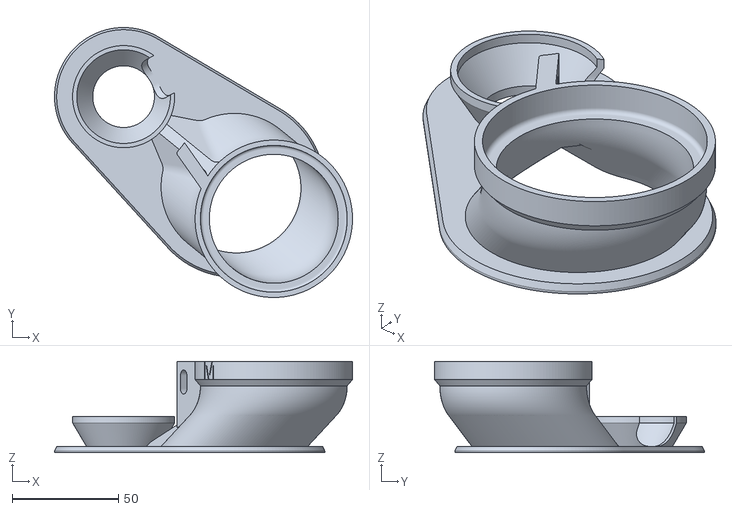
[picture p24: CAD file, 2026-10-22]
machine/delar/dust_shoe_makita.stl
140.1 x 126.9 x 43.0
