kingkongola/lowrider/machine/delar/nollpunkt/fallarm_C_arm.step

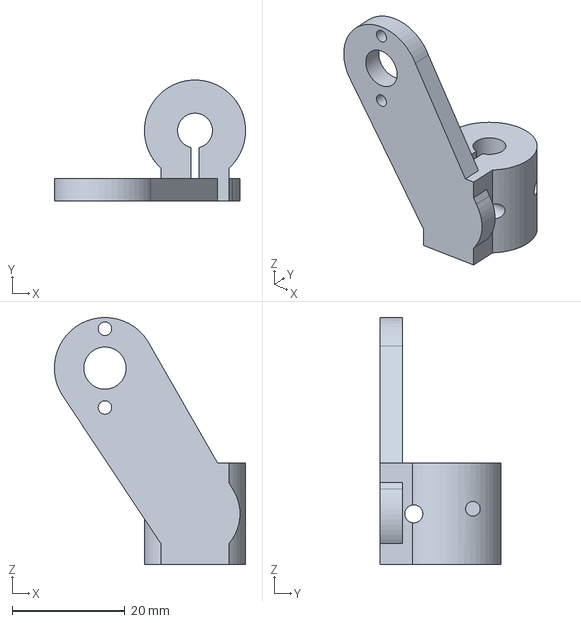
[picture p25: CAD file, 2026-11-05]
machine/delar/nollpunkt/fallarm_C_arm.step
34.0 x 21.5 x 43.9 mm
