kingkongola/lowrider/machine/delar/nollpunkt/fallarm_servo_bild.stl

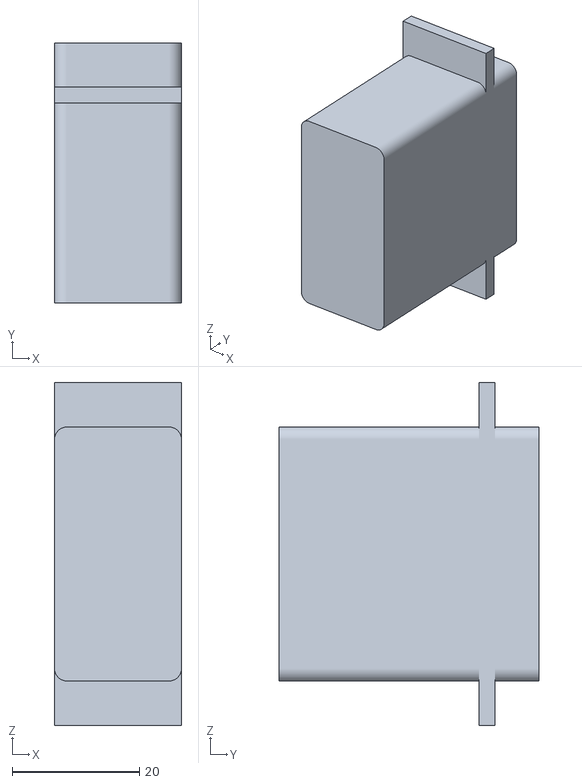
[picture p26: CAD file, 2026-11-05]
machine/delar/nollpunkt/fallarm_servo_bild.stl
20.0 x 41.0 x 54.0
