kingkongola/lowrider/machine/delar/plintkapa_lock.stl

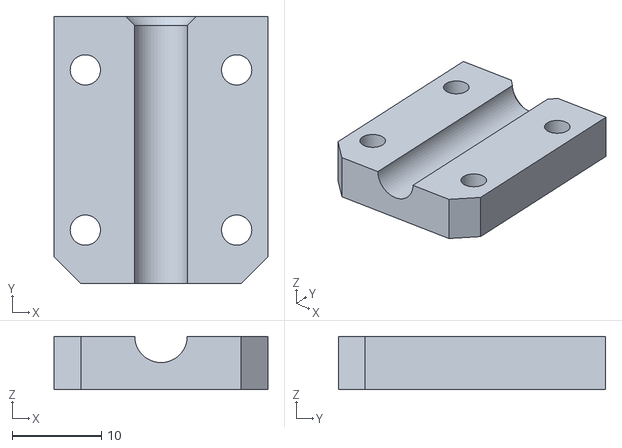
[picture p27: CAD file, 2026-10-22]
machine/delar/plintkapa_lock.stl
24.0 x 30.0 x 6.00
