kingkongola/lowrider/machine/delar/dinskena_ts35.stl

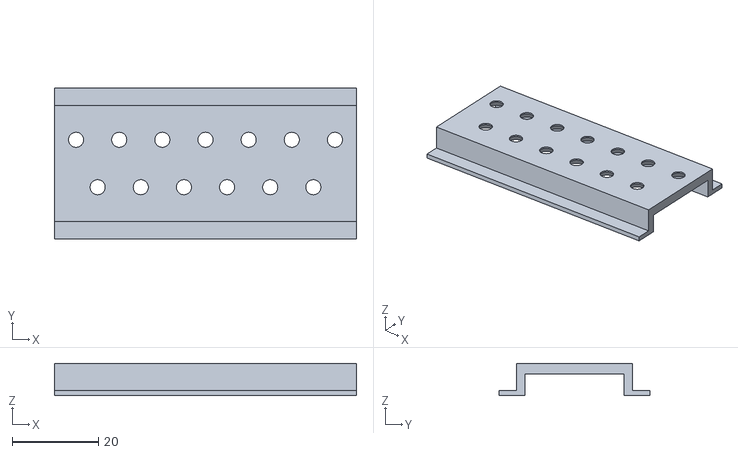
[picture p28: CAD file, 2026-10-22]
machine/delar/dinskena_ts35.stl
70.0 x 35.0 x 7.50
