kingkongola/lowrider/machine/delar/nollpunkt/fallarm_arm.step

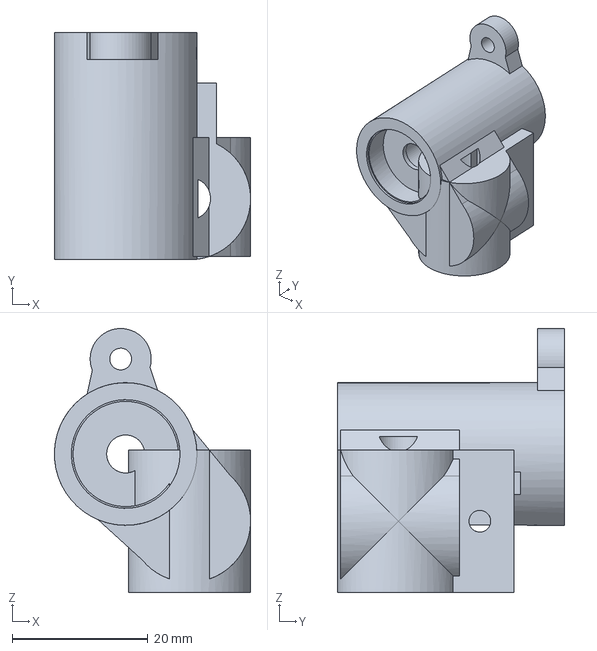
[picture p29: CAD file, 2026-11-05]
machine/delar/nollpunkt/fallarm_arm.step
28.9 x 33.5 x 38.9 mm
