kingkongola/lowrider/machine/delar/nollpunkt/fallarm_vev.step

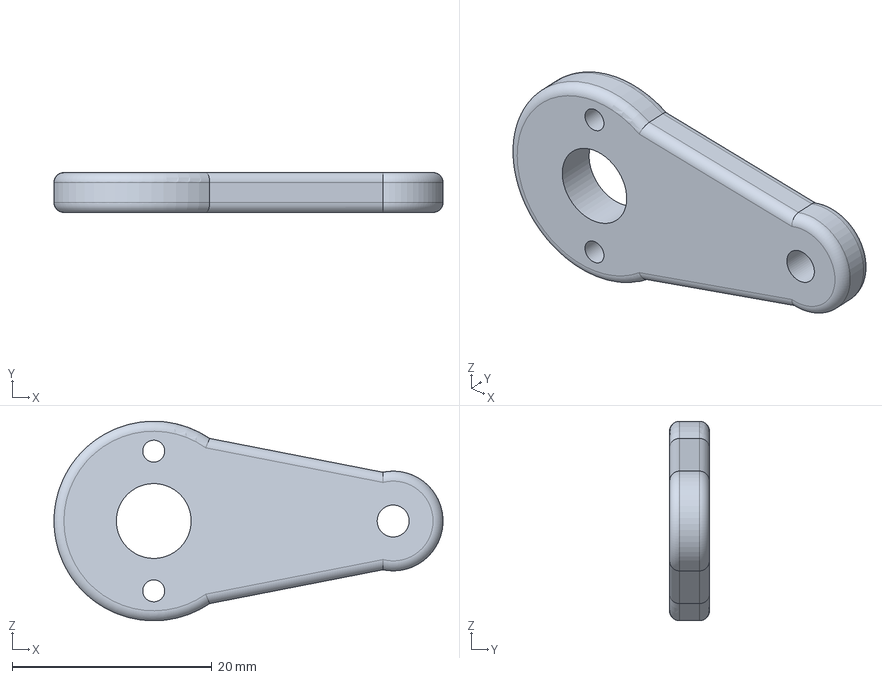
[picture p30: CAD file, 2026-11-05]
machine/delar/nollpunkt/fallarm_vev.step
39.0 x 4.00 x 20.0 mm
