kingkongola/lowrider/machine/delar/tpu-bristles-32mm-extra-long.stl

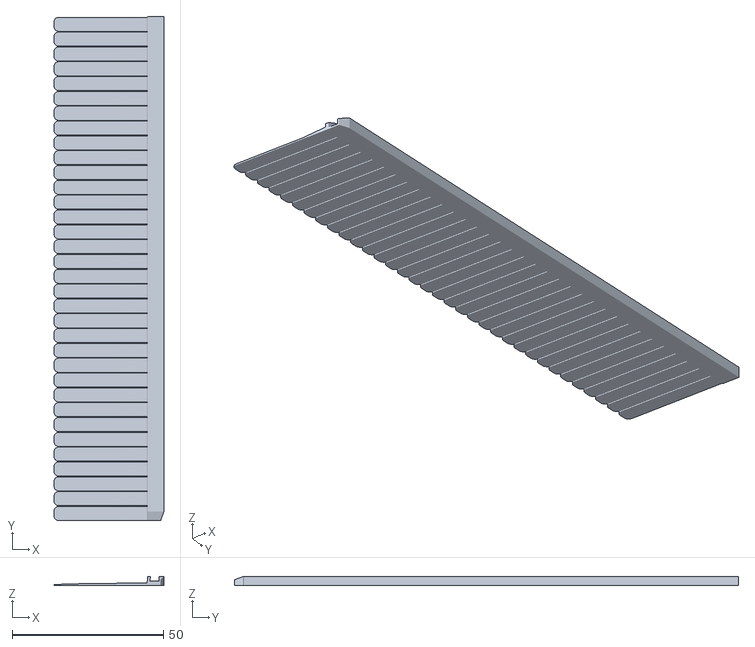
[picture p31: CAD file, 2026-10-22]
machine/delar/tpu-bristles-32mm-extra-long.stl
36.3 x 166.5 x 3.02
