kingkongola/lowrider/machine/delar/nollpunkt/attrapp_skaft.stl

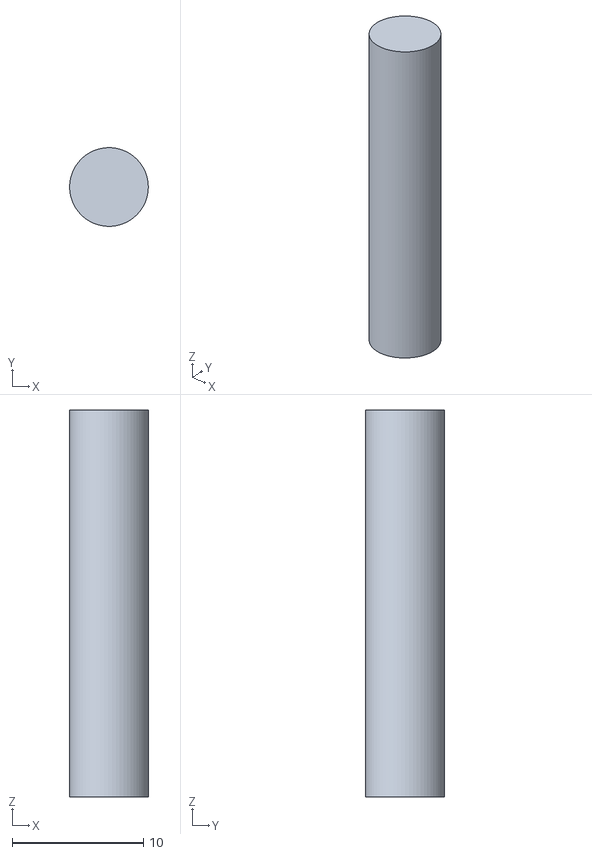
[picture p32: CAD file, 2026-11-05]
machine/delar/nollpunkt/attrapp_skaft.stl
6.00 x 6.00 x 29.5
