kingkongola/lowrider/machine/delar/nollpunkt/fallarm_C_servo_bild.stl

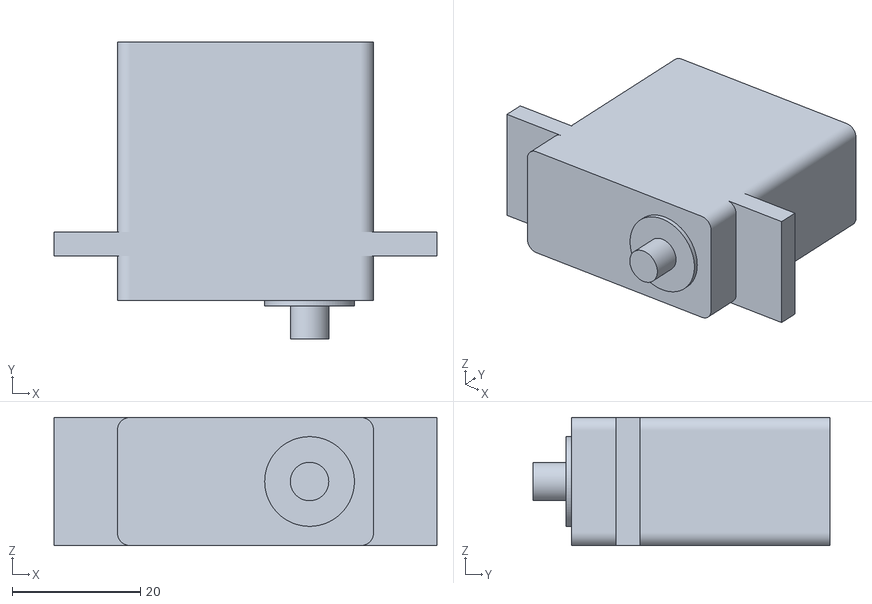
[picture p33: CAD file, 2026-11-05]
machine/delar/nollpunkt/fallarm_C_servo_bild.stl
59.8 x 46.4 x 20.0
