kingkongola/lowrider/machine/delar/nollpunkt/fallarm_kapa.step

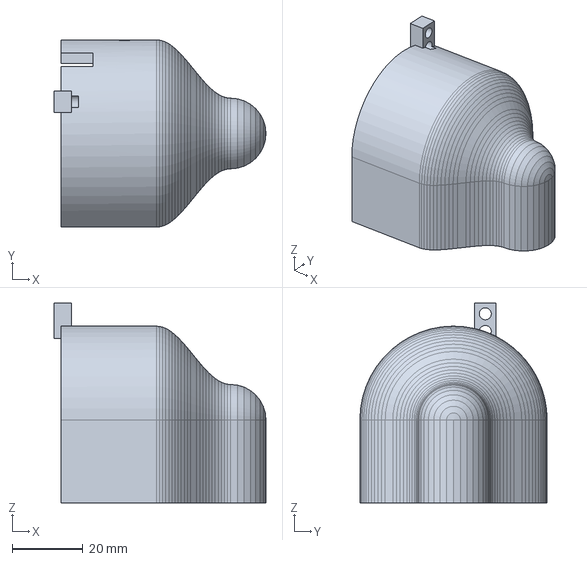
[picture p34: CAD file, 2026-11-05]
machine/delar/nollpunkt/fallarm_kapa.step
60.0 x 53.0 x 56.5 mm
