kingkongola/lowrider/machine/delar/nollpunkt/print_arm.stl

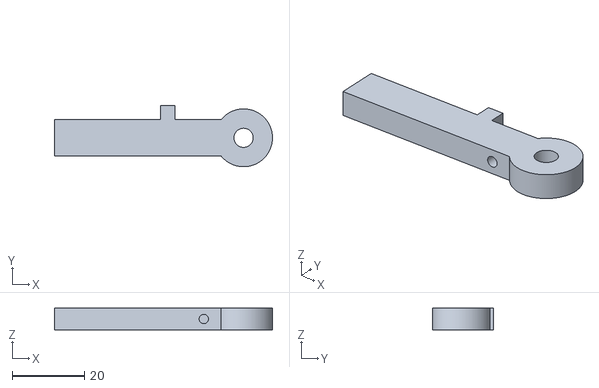
[picture p35: CAD file, 2026-11-05]
machine/delar/nollpunkt/print_arm.stl
60.3 x 17.0 x 6.00
