kingkongola/lowrider/machine/delar/nollpunkt/attrapp_kropp.stl

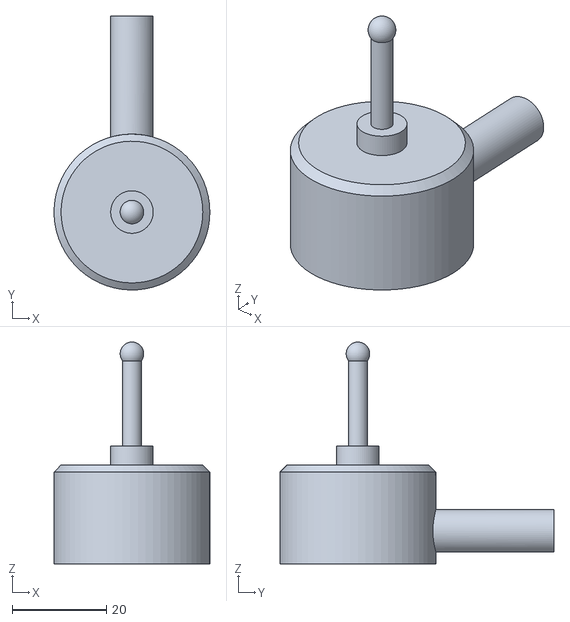
[picture p36: CAD file, 2026-11-05]
machine/delar/nollpunkt/attrapp_kropp.stl
33.0 x 58.0 x 47.0
