kingkongola/lowrider/(list of files, cad)

Other CAD files:
machine/delar/nollpunkt/print_C_faste.stl
machine/delar/tool-mount-b_makita.stl
machine/delar/nollpunkt/print_C_arm.stl
machine/delar/nollpunkt/provarm_faste.step
machine/delar/nollpunkt/print_C_kapa.stl
machine/delar/nollpunkt/provarm_arm.step
machine/delar/nollpunkt/fallarm_C_arm.stl
machine/delar/nollpunkt/fallarm_C_faste.stl
machine/delar/nollpunkt/fallarm_C_kapa.stl
machine/delar/nollpunkt/fallarm_arm.stl
machine/delar/nollpunkt/fallarm_faste.stl
machine/delar/nollpunkt/fallarm_kapa.stl
machine/delar/nollpunkt/fallarm_stag.stl
machine/delar/nollpunkt/fallarm_stag_B_alu.stl
machine/delar/nollpunkt/fallarm_vev.stl
machine/delar/nollpunkt/provarm_arm.stl
machine/delar/nollpunkt/provarm_faste.stl
