kingkongola/lowrider/machine/delar/nollpunkt/attrapp.printa/forhandsvisning.png

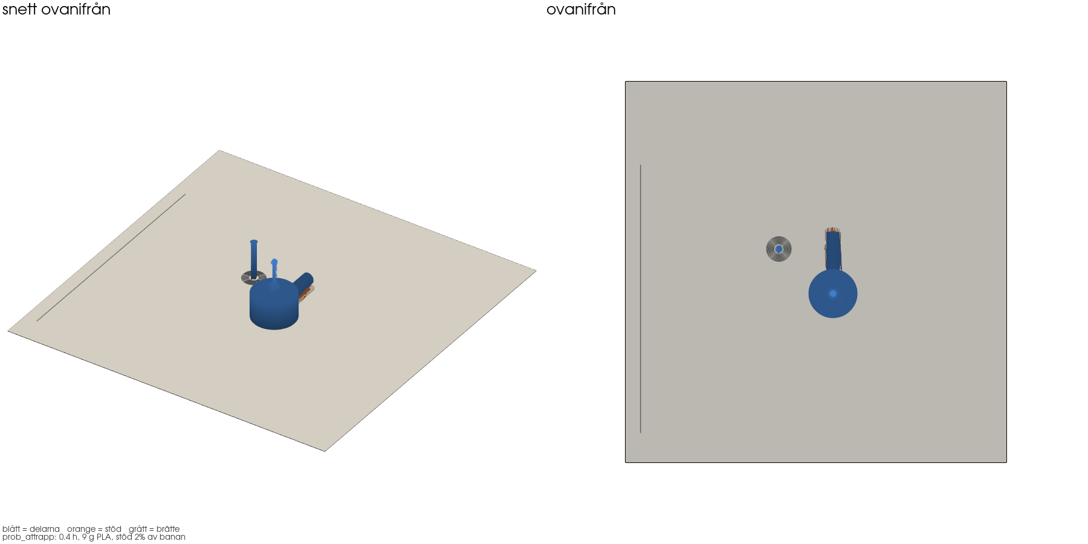
machine/delar/nollpunkt/attrapp.printa/forhandsvisning.png
