kingkongola/lowrider/machine/delar/nollpunkt/fallarm_C.printa/forhandsvisning.png

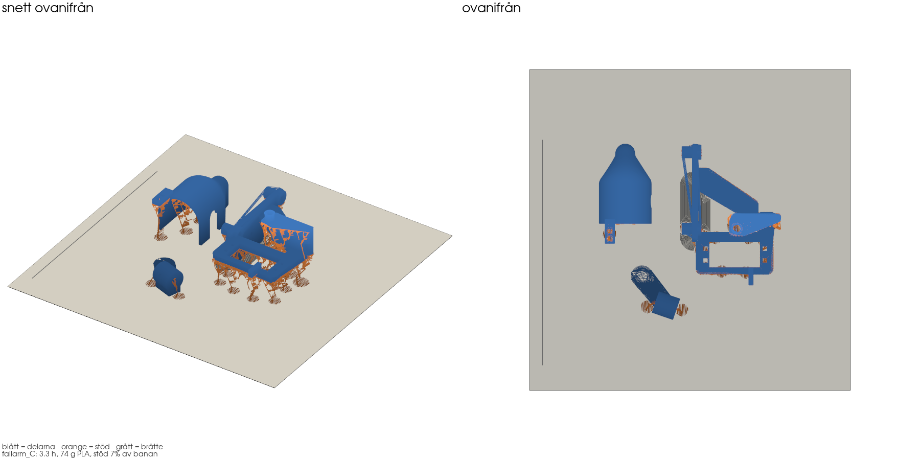
machine/delar/nollpunkt/fallarm_C.printa/forhandsvisning.png
