kingkongola/lowrider/BUILD_LOG.md

# Build log

## 2026-08-29 — initial design/procurement pass

- Privat GitHub-repo skapat för LowRider V4-bygget.
- Maskinvalet avslutat: LowRider V4.
- HaWiWe-order lagd och betald: 165,50 € inklusive 8,00 € frakt.
- Arbetsytan låst till 650 × 1250 mm.
- Exakt geometri: rör 816 / 816 / 1505 mm, strut 819, GT2 999 / 1705 / 1705 mm, minimum bord 941 × 1563 mm, deck ~1000×1620 mm.

## 2026-08-29 — oberoende system-/fysisk audit

- 24 V-rutten korrigerades till 3 m marginal + full-travel dry-fit.
- alla diameterberoende prints = 30 mm; strut `819` + `front_wing_size=30`.
- 90 cm bord godkändes med explicit kantstöd.
- KJD12 benämns NVR/maskinstopp, inte safety-rated E-stop.
- statisk jordning blev gate.

## 2026-08-30 — commissioning-audit

- T8 400 mm kapas efter assembly-check; ~150–160 mm ×2.
- microSD + data-USB-C inventeras före köp.
- endstops = home/auto-square, inte runtime hard limits.

## 2026-08-30 — sourcingoptimering

- DigiKey absorberade lågspänningskablar för att undvika separat order.
- PLA-behovet korrigerades till cirka 2,7 kg → köp 3 kg, inte 6 kg.

## 2026-09-03 — HaWiWe skickat + full repo reconciliation

- HaWiWe har skickat den redan betalda ordern.
- En tydlig kanonisk hierarki infördes: `PROCUREMENT.md` är enda ordermatrisen; BOM innehåller specs/kvantiteter; sourcing innehåller evidens; audit innehåller fysiska gates.
- Clas Ohlson KJD12 230 V/10 A verifierades till 299 kr som enkel NVR-kandidat.

## 2026-09-03 — verkliga kostnader + Jackpot3 köpt

- HaWiWe faktisk bankdebitering: **1 853 kr**.
- Jackpot3 `CQA240812C2` köpt från Elecrow: **937 kr** faktiskt debiterat.
- `COSTS.md` skapades som kanonisk ledger; SEK-debitering är facit framåt.

## 2026-09-03 — mekanik och commodity sourcing

- LaskaKit-order: 6 idlers, T8×8 400 mm, 2 kopplingar, 5 m GT2 10 mm; **444 kr** faktiskt debiterat.
- eBay/POWGE: 3 × 16T / 5 mm / 10 mm drive pulley; **72 kr** faktiskt debiterat.
- DigiKey: PSU, endstops, lager och el/lågspänningssmådelar; **986,98 kr** faktiskt debiterat.
- Amazon: 5 × STEPPERONLINE `17HS19-2004S1` samt KATSU `101750` beställda.

## 2026-09-05 — HKGY01 T8×8-muttrar annulleras

- eBay-säljaren meddelade out of stock och bad köparen annullera.
- **67 kr** ligger kvar i kostnadsloggen tills återbetalningen verifierats.

## 2026-09-05 — T8×8-muttrar ersättningsköpta via Amazon

- Amazon.se/euroharry: 4 × flänsad T8-mässingsmutter, Ø8 mm, 2 mm pitch, 4-start, 8 mm lead.
- Visat orderpris: **101,76 kr**.

## 2026-09-06 — 3 kg PLA köpt från PrintOnion

- **3 kg PLA 1,75 mm** köpt från PrintOnion för **426 kr**.
- Filamentbehovet för basbygget är stängt.
- Bordstrategin förenklades: ett styvt 180×90-bord använder sin egen skiva som maskinbas; ingen full extra deck som standard.

## 2026-09-07 — Motonet-rör köpta

- **2 stålrör** för LR4 köpta på Motonet för **340 kr totalt**.
- Planerad spec är `88-7123`, Ø30×1,5×2000 mm.
- Rörsourcingen är stängd; **kapa inte ännu**.
- Före kapning ska faktisk OD, rakhet och längd verifieras. Därefter målkapning: **1505 / 816 / 816 mm**.
- Verifierat faktiskt debiterat projektbelopp var då **5 125,98 kr**; aktiv committed cost exklusive HKGY01-annulleringen **6 389,11 kr**.

## 2026-09-09 — DigiKey-paket mottaget

- DigiKey-paketet hämtat/mottaget.
- Ordern innehåller PSU, endstops, 608-lager, Wago, glands, Faston, lågspänningskablage och board-pigtails enligt BOM.
- Leveransstatus ändrad till **RECEIVED**.
- Nästa gate är att räkna av innehållet mot BOM före montering; mottaget betyder ännu inte att varje del är fysisk-verifierad.

## 2026-09-10 — T8×8-mässingsmuttrar mottagna

- Amazon.se/euroharry-paketet med **4 × flänsad T8-mässingsmutter** mottaget i postlådan.
- Spec enligt beställningen: Ø8 mm, 2 mm pitch, 4-start, 8 mm lead.
- 2 används i LR4 och 2 blir reserv.
- Leveransstatus ändrad till **RECEIVED**.

## 2026-09-10 — alla hittills lagda köp debiterade

- Användaren bekräftade att **samtliga hittills lagda inköp är debiterade**.
- Amazon-orderna flyttades därför från väntande/committed till faktiskt betalt i `COSTS.md`.
- Debiterade Amazon-belopp enligt tidigare dokumenterade SEK-orderbelopp: motorer **608,37 kr**, KATSU **620,00 kr**, euroharry T8-muttrar **101,76 kr**.
- **Brutto faktiskt debiterat hittills: 6 456,11 kr.**
- **Aktiv faktisk projektkostnad exklusive HKGY01-order som väntar återbetalning: 6 389,11 kr.**

## 2026-09-18 — Jackpot3 mottagen

- Elecrow Jackpot3 `CQA240812C2` har kommit fram och är fysiskt mottagen.
- Leveransstatus ändrad till **RECEIVED**.

## 2026-09-19 — Bordsköp, remhjulsspårning och utskriftsläge

- Användaren rapporterade att begagnad **180×100 cm bordsskiva köpts för 300 kr**. Underredets skick/styvhet är ännu inte dokumenterat; ingen 90 cm-kantbreddning ska planeras.
- eBay/POWGE **3 × 16T-remhjul, redan köpta för 72 kr, är ännu inte mottagna**. eBay: importklarering 11 sep; senaste visade händelse `RECEIVED BY LMC / DEFRAA` 12 sep. Avvakta leverans och köp inte igen.
- Användaren printar **platta 10 av 14**.
- Permanent strut-plan enligt V1E: 4 printade temporära struts (15 % infill) vid montering; LR4 fräser sedan egna front-/bottenstruts ur 5–6 mm MDF/hardboard (max 6,35 mm). Generatorinställningar `strut_length=819`, `front_wing_size=30`.
- Betald brutto inklusive bordsskivan: **6 756,11 kr**. Aktiv kostnad exklusive annullerad eBay-order (67 kr) som väntar återbetalning: **6 689,11 kr**.

## 2026-09-21 — Tre 16T-remhjul mottagna

- Användaren bekräftar att **samtliga 3 × eBay/POWGE-remhjul** har kommit fram.
- Tidigare leveransblockerare för X/Y-remdrivning är därmed undanröjd. Verifiera fysisk variant: 16 tänder, 5 mm motoraxelhål och passning för 10 mm GT2-rem.
- Ingen ytterligare kostnad: **72 kr är redan bokförda** i `COSTS.md`. Denna leverans innebär inte att montering eller dimensionkontroll är utförd.

## 2026-09-21 — Verktygsfästet saknar bekräftad utskrift

- Användaren påpekade att den tidigare 14-plåtsplanen inte uttryckligen uppmanade till utskrift av ett Makita/65 mm-verktygsfäste.
- V1E:s separata Makita 701 Tool Mount and Dust Shoe är listad utanför huvuddelarna. **Vi vet inte om fästet fysiskt finns eller saknas; ingen fullständig inventering har återrapporterats.**
- Ny arbetsorder LR-00 kontrollerar rätt variant för KATSU 101750 (cirka 65 mm), startar separat utskrift vid behov och godkänner passning. LR-07 får inte förutsätta att fästet redan finns. Ingen ytterligare inköpskostnad är bekräftad.

## 2026-09-21 — Core omprintad; kabelmått saknades i arbetsordrar

- Användaren bekräftar att **hela Core är omprintad** och att nya utskriften **inte har den tidigare cirka 0,20 mm förskjutningen**. Gamla defekten är historik, inte ett aktivt fel; nya delen ska fortfarande vanlig passningskontrolleras.
- Arbetsordrarna saknade kaplängder för fem NC-brytare och motorförlängningar. Infört mätprotokoll `CABLE_ROUTING.md`: V1E har inget generellt exakt kapmått för vårt 650×1250-bygge. Mät respektive sträcka efter provmontering med X/Z/Y i rörelseextremer, dokumentera och kapa först då. Explicit V1E-mått för eventuell touchplate är minst 140 mm fri ledning vid Core.
- Köpta lager/motorer/kablar oförändrade, inga nya köp antagna.

## 2026-09-21 — Rättelse: X-brytarens 250 cm var inte verifierat

- Efter att kapmåttet 250 cm skrivits in i arbetsordrar och illustrerad guide granskades V1E:s originaltext. Originalet specificerar **ingen exakt längd för X-brytarens kabel** för vår maskinstorlek; endast minst 140 mm för *valfri touchplate* vid Core.
- **250 cm har dragits tillbaka som bindande kapinstruktion.** Mata kabeln från befintlig 10 m-rulle genom Core vid LR-08, prova hela X-slaget med avlastad kabelväg till Jackpot3 vid LR-16 och kapa först när faktisk längd är känd. Om användaren redan har kapat 250 cm, behåll biten och kontrollera räckvidden.
- Ändring synkad till `docs/MONTERING_SV.md`, `docs/index.html`, `docs/work-orders.json`, `WORK_ORDERS.md`, `CABLE_ROUTING.md`, `CHECKLIST.md` och `AUDIT.md`. Ingen fysisk kapning eller mätning är bekräftad.

## 2026-09-21 — Bekräftat mekaniskt passningsfel: X-brytarkabel

- Användaren har faktiskt provat den levererade **Tensility 30-00377, 3×26 AWG med cirka 4 mm svart mantel**: **den går inte genom Cores kabeltunnel**. Detta är inte längre en hypotetisk kontroll. Vårt kabelval var dåligt avstämt mot Core.
- Inget har kapats enligt användaren. Praktisk åtgärd att prova utan nytt inköp: avlägsna den svarta ytterkappan **bara över den korta trånga kanalens faktiska längd**, låt två individuellt isolerade ledare passera om de går fritt, behåll svart mantel på den yttre rörliga delen, ge mantelavslutningen dragavlastning och skydd mot skav. Ingen skadad ledarisolering får användas. Om detta inte fungerar skyddat: tunnare flexibel tvåledarkabel eller säker alternativ extern rutt.
- Kontrollera att den mantlade kabeln inte heller kolliderar med YZ-kanalerna innan någon kompletteringsorder görs. Endstopens slutliga längder och kontaktdon återstår att verifiera.

## 2026-09-29 – dokumentgranskning inför kapning och bygge

Svenska manualen och webbtexten har granskats mot V1E:s aktuella LR4-kalkylator, monteringsmanual, Jackpot3-dokumentation och Mean Wells HDR-underlag. Rörgeometrin bekräftad i kalkylatorkoden. Ovillkorlig T8-kapning till 150 mm återtagen till fysisk provpassning enligt D014; remmarginal och sågspår förtydligade. Kabelrullens fördelning och arbetsordningen rättad, inklusive LR-16 före LR-15 och LR-22 före LR-21. Separat granskningsprotokoll: [AUDIT_2026-09-29.md](AUDIT_2026-09-29.md).

Detta är dokumentändringar, inte rapport om utfört bygge. Inga fysiska kontroller, inköp eller leveranser har bockats av. Ändringarna är ännu inte publicerade på GitHub Pages.

## 2026-10-04 — kalibrering inleds

- Maskinen styrs över Wi-Fi (192.168.50.184, FluidNC 3.9.9). Hard limits på för alla fem brytare, soft limits X/Y/Z, travel 642/1240/98 mm, homad (användarens rapport 2026-10-03, bekräftad via config).
- Config-baslinje sparad i `machine/`. Kalibreringsprotokoll och logg i `CALIBRATION.md`; ordning steps/mm → squaring → Z-nivå.
- Kalibrering utförd (detaljer i `CALIBRATION.md`): X 50,0835 och Y 50,2054 steps/mm verifierade mot mätning; X-homing `mpos_mm` 2,99 (avrundning gav 2,995 mm); Y motor0 pulloff 6,2 / motor1 4,0 → diagonalskillnad 4,0 → 1,6 mm; Z-nivå uppskjuten. Controllern föll en gång tillbaka på Default-profil under sessionen (orsak ej fastställd; omstart räckte).

## 2026-10-07 — Offerskiva fastskruvad, fräsar mottagna

- Användaren rapporterar att **offerskivan är fastskruvad** på bordet. Material, tjocklek och kostnad ej rapporterade. Inte planfräst.
- **Fräsar har kommit med posten.** Typ, skaftdiameter, leverantör och kostnad ej rapporterade; bokförs i `COSTS.md` först när beloppet är känt.
- Ordning framåt oförändrad: litet skärprov (LR-24/25) → permanenta struts (LR-26/27/28) → planfräs offerskivan (LR-29) → Z-nivå och ny squaring (LR-30). Planfräsning före stagbytet görs inte, eftersom bytet ändrar balkens läge.

## 2026-10-07 — front_wing_size rättad

- `front_wing_size` är flikens utstick per sida på den främre stagplattan (plattan blir 67,5 + 2 × värdet mm hög), inte rördiametern. Generatorns kommentar: 8,0 för 32 mm-rör, **10,8 för 30 mm-rör**, 11,5 för 29,5 mm-rör. Tidigare `30` (ovan, 2026-08/09) var fel och är ersatt med **10,8** i alla aktuella filer. Bottenplattan har fast 5,5 i generatorn; dogbone 3,5 för 1/8"-fräs.
- Användaren rapporterar att **6,00 mm MDF är fastskruvad ovanpå offerskivan** inför stagplattorna. Fräsning ej utförd.

## 2026-10-16 — cyklon vald och utskrift påbörjad

- Jämförda modeller (MakerWorld): White Ghost kompakt (11 h, 5,0/85), VSC HF (23,4 h, 0,6 mm-nozzle, ingen ventil), Nanodesigner tvåstegs (50,9 h) och **eifelbiker med undertrycksventil** (18,7 h, 5,0/37, TPU-packningsprofil 1,7 h).
- **Vald: eifelbiker.** Skäl: inbyggd justerbar undertrycksventil löser kollapsrisken i uppsamlingskärlet (se `research/2026-08-29-cyclone-collection-container.md`), färdig TPU-packningsprofil, passar 30 l lockfat. Licens: MakerWorld Exclusive (personligt bruk).
- Användaren rapporterar att utskriften är påbörjad. Inte verifierad klar.
- Slangens ID är mätt till **46 mm** (rättat från 38 mm i BOM/CHECKLIST); dammskoadaptern `slangadapter_46mm` är printad (cnc-repot). Egna 46 mm-stosar till cyklonens portar återstår.
- Kvar: behållare (material, lockdiameter), slangens ytterdiameter, kontroll av insatser/skruvar/fjäder, vakuumtest av behållare och ventilinställning, statisk jordväg.

## 2026-10-22 — Offerskivan har en ofräst grop

- Användaren rapporterar att planfräsningen inte nådde en yta ungefär stor som A4 på offerskivan. **Rättat samma dag: det var en kulle, max ~0,25 mm, inte en grop**; 0,7 mm planfräsning (`plan07`) tar den. Trolig orsak enligt användaren: bordet är ojämnt (se CALIBRATION.md 2026-10-04, "bordet är inte plant") och offerskivan följer det. Gropens djup och läge ej uppmätt.
- Z-nivå (steg 3) ej gjord. Före tillverkning: mät gropen, välj djupare planfräsning eller shims under offerskivan, planfräs om, sedan Z-nivå och ny squaring.
- Användaren rapporterar att **de permanenta stagen (front/botten) är monterade** och att **dammsugningen är monterad**. Full X/Y/Z-rörelse med slangen ej verifierad; cyklonens status ej rapporterad.
- Plan: planfräs offerskivan ytterligare **0,7 mm** så att gropen tas, sedan Z-nivå (steg 3) och ny squaring. Planfilen görs om med `cnc plana` (filen `Planfras_offer_075` från 2026-10-15 är byggd före nuvarande postprocessor).
- Offerskivan var 9 mm MDF från början och har planats två gånger tidigare (0,5 mm per gång eller ~2 mm totalt, osäkert), plus 0,7 mm i dag (`plan07`). **Verklig tjocklek okänd och går inte att mäta vid kanten** (en ofräst ram runt den planade ytan). Användaren: styrhålen får gå så djupt fräsen räcker, även igenom offerskivan.
- **Planfräsning `plan07` klar 2026-10-22** (Ø22 planfräs, ratt 3, F1500, 0,7 mm). Användaren: ytan är plan nu, kullen borta. Ingen mätning med linjal/mätur rapporterad. Kvar: Z-nivå (steg 3) och ny squaring.
