kingkongola/lowrider/(commit log)

2026-08-29 Add LowRider BOM
2026-08-29 Document exact HaWiWe screw kit contents
2026-08-29 Verify VEVOR/Makita collet compatibility and clarify remaining BOM
2026-08-29 Update sourcing status after screw kit and collet verification
2026-08-29 Sync LowRider scope and current build status
2026-08-29 Mark HaWiWe order paid and correct VEVOR router BOM
2026-08-29 Prioritize dust control and current LowRider build steps
2026-08-29 Document procurement pass 1 for motors PSU and couplers
2026-08-29 Document motor, PSU and coupler procurement research
2026-08-29 research: document bearing and endstop sourcing with metadata
2026-08-29 research: document optimized LR4 wiring and connector strategy
2026-08-29 research: document LowRider machine power and NVR safety options
2026-08-29 research: isolate exact 16T drive-pulley sourcing
2026-08-29 Correct LR4 endstop model and bearing sourcing research
2026-08-29 Add Gävle steel tube sourcing research
2026-08-29 Add 3D-printed cyclone separator research
2026-08-29 Add spoilboard and permanent strut plate research
2026-08-29 Add structural center cassette material research
2026-08-29 Finalize LaskaKit mechanical cart with belt fallback
2026-08-29 Add 16T pulley and 608 bearing orphan cart research
2026-08-29 Add live StepperOnline motor order verification
2026-08-29 Lock PSU endstop and wiring procurement strategy
2026-08-29 Lock endstop cable and connector strategy
2026-08-29 Add wiring items to final LaskaKit cart
2026-08-29 Keep StepperOnline order motors-only after PSU check
2026-08-29 Lock HDR PSU and exact endstop wiring BOM
2026-08-29 Sync machine power architecture to HDR-60-24 decision
2026-08-29 Prefer Motonet 30x1.5 steel tube for LR4 rails
2026-08-29 Sync Motonet rails, live Jackpot3 and VEVOR purchase state
2026-08-29 Refine 16T pulley and 608 bearing procurement strategy
2026-08-29 Add DXV30SAPTA tool socket and auto-start research
2026-08-29 Lock DeWalt auto-start topology after verifying 2450W tool socket
2026-08-29 Add current purchase-ready LR4 order graph
2026-08-29 Add compact 230V enclosure and distribution research
2026-08-29 Sync compact mains enclosure and PLA plan into BOM
2026-08-29 Close 230V enclosure gap in purchase-ready order graph
2026-08-29 Prefer Biltema IP65 DIN enclosure over Clas Ohlson
2026-08-29 Sync Biltema enclosure and first cutter/workholding decisions
2026-08-29 Replace stale procurement plan with current order graph
2026-08-29 Reconcile sourcing file with current locked carts
2026-08-29 Broaden used table target to 160-180 cm
2026-08-29 audit: reconcile sourcing with current procurement
2026-08-29 audit: reconcile procurement with physical cable routing
2026-08-29 audit: reconcile BOM with physical integration
2026-08-29 audit: reconcile geometry research with 30 mm rail choice
2026-08-29 Add vacuum vessel and upstream circuit gates
2026-08-29 Reconcile KJD motor rating and cyclone vacuum gate
2026-08-29 Record P1S printer and 10A garage circuit
2026-08-29 Resolve P1S print gate and record 10A garage circuit
2026-08-29 Resolve P1S capability and add 10A power constraint
2026-08-29 Resolve KJD12 variant and 10A router current ambiguity
2026-08-29 Reconcile audit with P1S, 10A circuit and live carts
2026-08-29 Treat 10A garage circuit as known working constraint
2026-08-29 De-escalate proven 10A circuit and record live belt stock issue
2026-08-29 Reconcile belt stock and de-escalate proven 10A circuit
2026-08-29 Reconcile belt source and 10A evidence
2026-08-29 Reconcile sourcing with live belt stock and cart audit
2026-08-29 Resolve GT2 belt source and simplify 10A commissioning
2026-08-29 Correct live belt stock and record proven 10A circuit
2026-08-30 Right-size PLA purchase to actual 2.7 kg LR4 need
2026-08-30 Switch controller baseline to Jackpot2
2026-09-03 Lock current PLA path and refine landed-cost gates
2026-09-03 Fix Allegro Tr8x8 nut variant
2026-09-03 Replace non-EU pulley source with DMW Germany
2026-09-03 Point 16T pulley sourcing to Germany
2026-09-03 Use DMW Germany for 16T pulleys
2026-09-03 Record eBay pulley purchase
2026-09-03 Mark GT2 drive pulleys purchased
2026-09-03 Close pulley sourcing after eBay purchase
2026-09-03 Reconcile README after eBay pulley purchase
2026-09-03 Reconcile checklist after eBay pulley purchase
2026-09-03 Reconcile sourcing after eBay pulley purchase
2026-09-03 Log eBay pulley purchase
2026-09-03 Update current status after LaskaKit order
2026-09-03 Record eBay T8x8 brass nut purchase
2026-09-03 Close T8x8 brass nut orphan purchase
2026-09-03 docs: replace dead motor/router sourcing paths
2026-09-03 docs: record Amazon motors and Katsu router purchase
2026-09-03 docs: close Amazon motor and router sourcing
2026-09-03 docs: add pending Amazon motor and router orders
2026-09-05 docs: record cancelled T8 nut order
2026-09-05 docs: record Amazon T8x8 nut replacement order
2026-09-05 docs: add Amazon T8 nut order to cost ledger
2026-09-05 docs: close T8 nut procurement task
2026-09-05 docs: log Amazon replacement T8 nut order
2026-09-05 docs: close T8 nut sourcing with Amazon replacement
2026-09-06 docs(lowrider): record PrintOnion PLA purchase
2026-09-06 docs(lowrider): add PrintOnion filament cost
2026-09-06 docs(lowrider): log PrintOnion PLA purchase
2026-09-06 docs(lowrider): close PLA sourcing via PrintOnion
2026-09-06 docs: align BOM with direct-table baseline
2026-09-06 docs: keep plasma as future project and reconcile current build decisions
2026-09-07 Record Motonet tube purchase
2026-09-07 Close Motonet tube sourcing
2026-09-07 Mark Motonet tubes purchased
2026-09-07 Log Motonet tube purchase
2026-09-10 Reconcile all current purchases as debited
2026-09-10 Mark all current purchases as debited
2026-09-19 SSOT: record 300 kr 180x100 table and pending pulley delivery
2026-09-19 SSOT: reconcile purchased table, pulley tracking and strut bootstrap plan
2026-09-21 docs: link Swedish LR4 assembly guide from README
2026-09-21 docs: record conditional PSU mounting decision D016
2026-09-21 docs: correct PSU mounting plan in Swedish assembly guide
2026-09-21 docs: clarify single Y guide rail
2026-09-21 docs: clarify single Y guide rail in illustrated site
2026-09-21 feat: show original V1E assembly images directly beside Swedish steps
2026-09-21 docs: include YZ back wheels and Z endstop check before T8 cutting
2026-09-21 docs: align YZ rear wheel images and belt photos with illustrated Swedish steps
2026-09-21 ssot: mark POWGE pulleys received 2026-09-21
2026-09-21 ssot: update pulley receipt in BOM
2026-09-21 ssot: mark pulley arrival and add physical spec gate
2026-09-21 ssot: log received three eBay drive pulleys
2026-09-21 ssot: reconcile table power supply note with D016
2026-09-21 docs: reflect received 16T pulleys in Swedish build guide
2026-09-21 ssot: reconcile audit with received eBay pulleys
2026-09-21 docs: update pulley status and link one-hour work orders
2026-09-21 docs: specify Core hardware quantities and exact assembly sequence in LR-07
2026-09-21 docs: flag missing separately printed KATSU mount and add LR-00 gate
2026-09-21 docs: gate Core mounting on separately printed router mount LR-00
2026-09-21 docs: show missing router mount gate in published illustrated manual
2026-09-21 ssot: update Core status and gate cable cuts on measured full travel
2026-09-21 ssot: link actual wire inventory to cable length measurement
2026-09-21 ssot: log reprinted Core and cable-cut dependency
2026-09-21 docs: create measured cable-routing and cut-length protocol for actual LR4
2026-09-21 docs: log reprinted Core and measured cable policy
2026-09-21 docs: document motor and limit wire length acceptance gate
2026-09-21 docs: link cable routing sheet in SSOT
2026-09-21 docs: add cable-measurement job LR-16B and reconcile Core reprint in work orders
2026-09-21 docs: synchronize 32 one-hour jobs with measured-cable order and Core reprint
2026-09-21 docs: update inline manual for reprinted Core and measured wiring lengths
2026-09-21 docs: specify 250 cm X-endstop lead at Core installation step
2026-09-21 docs: specify 250 cm X endstop lead directly by Core photos
2026-09-21 docs: replace cable measuring hour with 250 cm X lead cut at LR-08
2026-09-21 docs: sync 31 work orders with direct Core cable cut length
2026-09-21 docs: define 250 cm Core X endstop cut and remove unnecessary length-measuring hour
2026-09-21 ssot: align Core X cable pre-cut with build guide
2026-09-21 docs: remove stale references to deleted cable-measuring order
2026-09-21 docs: retract unverified 250 cm Core cable cutting instruction
2026-09-21 docs: retract unverified 250 cm instruction in public build guide
2026-09-21 docs: retract unverified X lead cut from LR-08 and LR-16
2026-09-21 docs: align 31 work orders with no-cut Core instruction
2026-09-21 ssot: retract unverified 250 cm cable-cut dimension
2026-09-21 ssot: log retraction of unverified 250 cm wire cut
2026-09-21 docs: identify actual 4 mm 3-core limit cable and require Core clearance check
2026-09-21 docs: caution about 4 mm limit cable fit in Core
2026-09-21 docs: record actual 4 mm cable failure and local sheath solution for Core
2026-09-21 docs: update illustrated Core guide for actually oversized switch cable
2026-09-21 docs: record confirmed 4mm cable obstruction and actionable Core alternatives
2026-09-21 docs: update LR-08 with actual cable fit failure and protection
2026-09-21 ssot: record confirmed Core cable fit failure and practical alternatives
2026-09-21 ssot: log confirmed oversized switch cable and remediation
2026-09-21 docs: retain planned touchplate and distinguish its Core lead from X switch
2026-09-21 docs: show planned touchplate routing alongside Core switch
2026-09-21 procurement: confirm DeWalt hose too short; shortlist 38 mm long CNC hose
2026-09-21 dust extraction: test existing 38 mm pool hose before buying
2026-09-21 SSOT: confirm existing 4 m 38 mm pool hose compatible with DeWalt
2026-10-04 calibration: X/Y steps/mm, squaring protocol and log, config backups from machine
    Adds CALIBRATION.md (protocol + measurement log), machine/ config backups,
    and syncs README, CHECKLIST, WORK_ORDERS, BUILD_LOG and CLAUDE.md.
2026-10-07 SSOT: front_wing_size 30 -> 10,8; strutplattor g-kod
    - front_wing_size är flikens utstick (generatorn: 10,8 för 30 mm-rör), inte rördiametern; rättat i alla aktuella filer.
    - strut_plate.svg (strut_length=819, num_braces=6, dogbones 3,5, wing 10,8) och g-kod i machine/gcode/ (skarp + luftkörning) med generator.
    - BUILD_LOG: rättelse och rapport om 6,00 mm MDF fastskruvad.
2026-10-22 Permanenta stag och dammsugning monterade; plan för 0,7 mm planfräsning
2026-11-05 Config: Z-fart 800 mm/min, uppladdad och verifierad (SHA-256, max_rate efter omstart)
2026-11-06 docs: capture camera constraints and autonomous workholding/indexing ideas
2026-11-08 procurement: registrera sensorer som beställda, ej mottagna
2026-11-08 docs: förtydliga ansvar, sensorbeställning och aktuell arkitektur
2026-11-08 docs: definiera två fysiska servoändlägen med återbrukade Omron-brytare
2026-11-08 BOM: återanvänd köpta ändlägesbrytare för servoarm
2026-11-08 docs: länka gemensam sensorjournal utan dubbel information
2026-11-08 docs: dokumentera M66, samkopplade G38-probingångar och servostartsrisk
2026-11-08 docs: hitta Opus CAD vC och planera modulär gemensam Core-enhet utan nya hål
2026-11-08 docs: precisera riktad 2.5D-probskanning med ledande BLTouch och kollisionsvillkor
2026-11-09 docs: bekräfta Electrokit-order med Standard Camera Module 3 och faktiskt angivna orderrader
2026-11-09 docs(camera): provbelysning först, endast eventuell liten diffuserad Core-LED
2026-11-09 docs: reconcile current calibration, old probe decision and verified camera CI
2026-11-09 cad: printable preliminary Pi Zero case, Camera 3 plate and vertical BLTouch direct servo arm
2026-11-09 docs(electrical): Core kamera/Pi, servo, BLTouch och två gränslägen utan antagna GPIO
2026-11-09 docs(cad): provprintningsordning, fanless beslut, referensmått och osäkerheter
2026-11-09 ci(cad): export five printable prototypes and validate watertight mesh
2026-11-09 ci(cad): installera graph engine för STL-komponenttest
2026-11-09 docs: lägg till beställd kamera, prov-CAD och beslutsgränser för Core
2026-11-09 docs: prototyp-CAD, fläktlös Pi, kopplingsskiss och bekräftade CI-tester
2026-11-09 cad: build123d modulär Core-rygg med kabelkanal och oberoende sensor-, servo- och Pi-kassetter
2026-11-09 ci(cad): build123d-export och kvalitetskontroll av modulär sensorbärare
2026-11-09 ci(cad): pin compatible ocp_gordon 0.2.x for build123d 0.10 OCP 7.8
2026-11-09 test(cad): ange vilken modul som har separata solids innan export
2026-11-09 fix(cad): fäst kamerans stöd i plattan, korrigera BLTouch till utfällt stiftmått 45,7 mm
2026-11-09 fix(cad): servicefria modulskarvar, fri kameralins, rätt Pi-dockning och två BLTouch-skruvar
2026-11-09 ci(cad): diagnostik för STL-meshernas sammanhängande komponenter
2026-11-09 fix(cad): fäst Pi-skruvpelarna med volumetrisk överlappning mot botten
2026-11-09 ci(cad): lokalisera trasiga STL-kanter och bevara analysartefakter även vid fel
2026-11-09 fix(cad): stäng Pi-kapslingens fyra nolltjocka hörn och justera lockets passning
2026-11-09 test(cad): BRep-intersektion mellan sensormoduler och referens-STL från befintlig Core
2026-11-09 ci(cad): rendera och kvalitetsgranska hela sensorenhetens modularitet mot original-Core
2026-11-09 fix(cad): normalisera build123d Vector till XYZ vid kollisionsgranskning
2026-11-09 fix(cad): inga kabelkåpekonflikter, accelerometer på distanser och separat mikrofonpod på Pi-låda
2026-11-09 fix(cad): hantera tomma BRep-kontakter och inkludera befintlig servo som extern referens
2026-11-09 test(cad): kontrollera BLTouch-armens och probkroppens svep 0–90° mot samtliga moduler och servoskissen
2026-11-09 feat(cad): exportera färgkodad 3D-montering med riktiga Core-referenser som separata GLB-noder
2026-11-09 ci(cad): leverera visningsbar 3D-sensorenhet på befintlig Core som GLB
2026-11-09 docs(cad): build123d nu enda gällande sensorenhet; printgrindar, modularitet och verifierat montage
2026-11-09 chore(cad): ta bort gamla OpenSCAD-CI efter verifierad build123d-ersättning
2026-11-09 docs(cad): märk gammal OpenSCAD-arm som inaktuell för utskrift
2026-11-09 docs: gällande build123d-sensorenhet, arkiverad OpenSCAD, verifierade modularitetsgränser
2026-11-09 docs(cad): tydliggör att Pi-kapslingens kabelöppning inte är spåntät
2026-11-09 cad: universal justerbar KW11-3Z-N hållare, printa två identiska
2026-11-09 cad: två löstagbara KW11-hållare på separat servokassett, inga nya Core-hål
2026-11-09 test(cad): två identiska KW11-hållare som separata monteringsobjekt i BRep och GLB
2026-11-09 ci(cad): bygg 11 separata CAD-delar och visa två monterade KW11-hållare
2026-11-09 docs: build123d KW11-fästen grön CAD, Omron-reserv och öppna mekaniska stopp
2026-11-09 docs: KW11-brytarköp och separat CAD-monteringsgrind för sensorarmen
2026-11-09 cad: två oberoende KW11-3Z-N brytarkassetter med justerbara M2 och M3 på servokassett
2026-11-09 ci(cad): testa 12 separata sensormoduler med två KW11-hållare
2026-11-09 cad: visualisera 2 utbytbara KW11-hållare med separata måttproxyer i 3D-montage
2026-11-09 cad: lägg in användarens QUARKZMAN-mått som konservativa KW11-referensatrapper
2026-11-09 cad: visa två måttbaserade KW11-brytaratrapper, kontrollera kroppar i servo-svep
2026-11-09 fix(cad): behåll en KW11-hållarmodell istället för dubblerade fästen
2026-11-09 docs(cad): transkribera köpt QUARKZMAN-brytares mått och märkning från Amazonbild
2026-11-09 cad: inkludera riktiga brytarreferenser som ej printbara objekt i 3D-montage
2026-11-09 test(cad): mät rullkontakt mot roterande arm och visa verklighetsnära KW11-attrapper i 3D
2026-11-09 fix(cad): visa en KW11-referens per brytare och flagga uppmätt utebliven armaktivering
2026-11-09 ci(cad): behåll rullstatus som tydlig varning utan att låsa framtida mekaniska förbättringar
2026-11-09 cad(sensor): sidotorn v2 med hårda stopp, rak kamera och LED-spår
2026-11-09 cad(sensor): Pi-rum och kabelvägar i sidotornet, D020 utan armbrytare
2026-11-09 cad(sensor): dolda kabelvägar, sidopanel och formad kameranos på sidotornet
2026-11-09 cad(sensor): servokåpa i sidotornet, servopaket flyttat 2 mm
2026-11-09 cad(sensor): organisk BLTouch-arm, magnetparkering, rundade former och kabel ut längs Core
2026-11-09 cad(sensor): svepande tornsiluett, mjukare servoram och Ø6-magnet i parkeringsstoppet
2026-11-09 cad(sensor): M3-skruv mot magneten och LM2596-regulator med luftväg i sidotornet
2026-11-09 cad(sensor): Pi inne i tornet, kamerafäste efter tillverkarens mått och CSI-rum för 16 mm flatkabel
2026-11-09 cad(sensor): två LM2596, 5,1 V och 6,0 V till servot, och sluten vägg runt kamerafickan
2026-11-09 cad(sensor): M3-klämning av kameran, panelfingrar mot Pi och LM2596, magnet bakifrån och pinnar valda (D021)
2026-11-09 cad(sensor): hylsa som skyddar BLTouchen i alla lägen, M3 direkt i armens fot
2026-11-09 cad(sensor): ADXL345 på massiv platta vid övre M5, den ska mäta fräsningens vibrationer
2026-11-09 cad(sensor): buntbandsbryggorna fästa i bakväggen, inte lösa i kabelöppningen
2026-11-09 cad(sensor): bryggan tangerade panelpelaren och gav otät STL
2026-11-10 SSOT: document LED beam geometry, existing supplies and independent monitoring stop
2026-11-10 SSOT: link power, lighting and monitoring requirements
2026-11-10 SSOT: inventory chosen COB lighting and remaining power/clip tasks
2026-11-10 docs: mark outdated Pi-from-Jackpot supply in sensor wiring draft
2026-11-10 cad: add parametric three-angle 8mm COB holder for LR4 strut edge
2026-11-10 ci: export and validate parametric LED COB clamp STEP/STL
2026-11-10 docs: record parametric LR4 LED clip geometry and validation gates
2026-11-10 SSOT: record parametric printed LED clip, optional aluminum and validation
2026-11-10 docs: link LED clip prototype in bill of materials
2026-11-10 fix(cad): attach 3-way COB LEDs to horizontal LR4 bottom strut M5 holes
2026-11-10 docs: retract 90-degree strut error and document bottom-plate M5 mounting
2026-11-10 SSOT: retract wrong 90-degree LED strut clamp, document true horizontal bottom plate and M5 pattern
2026-11-10 docs: retract invalid strut clamp and track corrected horizontal M5 mount
2026-11-10 SSOT: replace obsolete camera-light plan with D022 COB decision
2026-11-10 docs(cad): label optional camera LED slots as superseded by D022
2026-11-10 docs: make D022 LED decision visible in LowRider README
2026-11-10 docs: supersede unused camera LEDs and stale Pi power assumptions
2026-11-10 SSOT: clarify BOM supersedes G4 and Prime price
2026-11-10 SSOT: explicitly supersede stale D017 no-new-LED plan
2026-11-10 docs: expose current D022 COB instead of G4 to coding agents
2026-11-10 docs: track LED installation gates and superseded G4 in checklist
2026-11-10 docs: reflect CAD sources and tests in agent repository scope
2026-11-10 cad: round LED holder corners and chamfer exposed rails; reserve cable route for dry-fit
2026-11-10 docs: specify cable feed/drill gate and parametric styled LED clip
2026-11-10 SSOT: cable drilling decision gate and rounded/chamfered LED clip status
2026-11-10 docs: add LED cable passage and appearance verification to installation checklist
2026-11-10 docs: document LED wiring path and conditional strut hole in cable routing
2026-11-10 cad: replace hanging LED rails with Z-budgeted low-profile mount
2026-11-10 SSOT: D022 require minimal Z loss and 6.2mm low-profile design
2026-11-10 SSOT: make minimal Z intrusion top LED mounting priority
2026-11-10 docs: replace old LED clip checklists with hard Z bound
2026-11-10 docs: replace hanging LED brackets with 6.2mm Z-budgeted low profile
2026-11-10 ci: enforce 6.2mm low-profile LED Z envelope and reject 50-degree default
2026-11-10 docs: announce minimal-Z LED bracket in repo overview
2026-11-10 docs: sync BOM with LED clip Z-budget
2026-11-10 docs: require minimal-Z CAD in Claude instructions
2026-11-10 docs: require minimal-Z CAD in agent instructions
2026-11-10 cad: brace 15/25-degree COB rails with longitudinal gussets and roof without Z loss
2026-11-10 SSOT: add structural reinforcement to 25 degree LED without Z penalty
2026-11-10 docs: add structural LED rib and free-end test
2026-11-10 docs: reconcile reinforced LED rail design in BOM
2026-11-10 docs: tell Claude about strengthened Z-neutral COB mounting
2026-11-10 cad: use 30-degree front COB rail with 9mm support within 6.2mm Z budget
2026-11-10 docs: print checks for 30 degree bracket and LED thickness
2026-11-10 docs: update BOM to 30 degree LED carrier
2026-11-10 SSOT: select 30 degree reinforced LED rail within 6.2mm Z budget
2026-11-10 SSOT: 30 degree LED with 9mm carrier and measured CAD Z
2026-11-10 docs: sync 30 degree LED CAD, narrowed carrier and print gates
2026-11-10 docs: update Claude instructions with 30 degree bracket
2026-11-10 docs: update coding-agent instructions with 30 degree bracket
2026-11-10 ci: assert 30-degree LED fits 6.2mm only on 9mm rail
2026-11-10 cad: accept 35-degree LED rail at approximately 6.6mm Z intrusion
2026-11-10 ci: permit 35-degree 9mm LED holder within 6.65mm Z bound
2026-11-10 docs: refresh 35-degree LED holder details and mount gates
2026-11-10 SSOT: D022 accept 35-degree COB rail with approx 6.6mm holder protrusion
2026-11-10 SSOT: consolidate 35-degree LED geometry and corrected testing status
2026-11-10 docs: sync 35-degree LED choice and 6.65mm CAD Z guard
